berndoJ/BerndoKeyboard/firmware/doc/latex/index.tex

\hypertarget{index_intro_sec}{}\doxysection{Introduction}\label{index_intro_sec}
This is the documentation for the Berndo\+Keyboard-\/\+Firmware project.
