berndoJ/BerndoKeyboard/firmware/doc/latex/main_8h.tex

\hypertarget{main_8h}{}\doxysection{app/inc/main.h File Reference}
\label{main_8h}\index{app/inc/main.h@{app/inc/main.h}}

The main entry point of this application.  

\doxysubsection*{Functions}
\begin{DoxyCompactItemize}
\item 
int \mbox{\hyperlink{main_8h_a840291bc02cba5474a4cb46a9b9566fe}{main}} (void)
\begin{DoxyCompactList}\small\item\em Main function entry point of this application. This function is called by the startup assembly file startup\+\_\+stm32f103xe.\+s. \end{DoxyCompactList}\end{DoxyCompactItemize}

\doxysubsection{Detailed Description}
The main entry point of this application. 

\begin{DoxyDate}{Date}
03.\+01.\+2020
\end{DoxyDate}
\begin{DoxyAuthor}{Author}
Johannes Berndorfer (berndoJ) 
\end{DoxyAuthor}
\begin{DoxyCopyright}{Copyright}
Copyright (c) 2020 by Johannes Berndorfer (berndoJ) 
\end{DoxyCopyright}

\doxysubsection{Function Documentation}
\mbox{\Hypertarget{main_8h_a840291bc02cba5474a4cb46a9b9566fe}\label{main_8h_a840291bc02cba5474a4cb46a9b9566fe}} 
\index{main.h@{main.h}!main@{main}}
\index{main@{main}!main.h@{main.h}}
\doxysubsubsection{\texorpdfstring{main()}{main()}}
{\footnotesize\ttfamily int main (\begin{DoxyParamCaption}\item[{void}]{ }\end{DoxyParamCaption})}

Main function entry point of this application. This function is called by the startup assembly file startup\+\_\+stm32f103xe.\+s. 

\begin{DoxyReturn}{Returns}
Status code. 
\end{DoxyReturn}
