berndoJ/BerndoKeyboard/hardware/BerndoKeyboard-Switchboard/BerndoKeyboard-Switchboard.PcbDoc.htm

Reporting Options

# File in Previous Format

Date | : | 11.01.2020
Time | : | 12:33:09
Filename | : | C:\Users\Johannes\Documents\GitHub\BerndoKeyboard\hardware\BerndoKeyboard-Switchboard\BerndoKeyboard-Switchboard.PcbDoc

Version | Warning

This file was generated by an earlier version of the software
