berndoJ/BerndoKeyboard/kb_layout/keyboard-layout.png

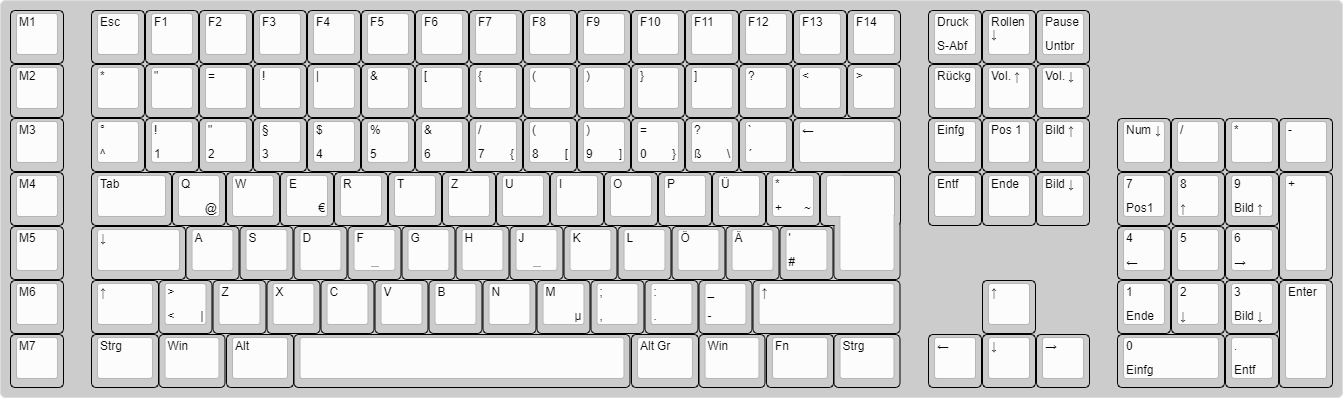
kb_layout/keyboard-layout.png
