berndoJ/BerndoKeyboard/hardware/BerndoKeyboard-Switchboard/BerndoKeyboard-Switchboard-OrderList-LCSC.xlsx

Count | Part Ref | P/N
15 | CCER000002 | C1525
1 | CCER000013 | C70464
132 | D000002 | C77978
1 | TVS000004 | C7519
11 | LED000007 | C114586
26 | R000016 | C60490
7 | R000006 | C114759
2 | R000017 | C105872
1 | R000020 | C163475
1 | R000021 | C327333
2 | IC000051 | C128392
1 | IC000052 | C7843
