berndoJ/BerndoKeyboard/hardware/BerndoKeyboard-Switchboard/BerndoKeyboard-Switchboard-BillOfMaterials.xlsx

Sheet: Raw BOM Data
Comment | Description | Designator | Footprint | LibRef | Quantity | Internal Part Number | Supplier 1 | Supplier Order Qty 1 | Supplier Unit Price 1 | Supplier Subtotal per Board 1 | Supplier Part Number 1
PTS645SL50SMTR92LFS | BTN TACT SPST-NO 12V 50mA SMD BLACK | BTN1 | BTN-SMD-PTS645-CK | PTS645SL50SMTR92LFS | 1 | BTN000006 | Digi-Key | 1 | 0.27882 | 0.27882 | CKN9088CT-ND
MX1A-E1NW | BTN CHERRY MX BLUE SPST-NO 12V 10mA | BTN2, BTN3, BTN4, BTN5, BTN6, BTN7, BTN8, BTN9, BTN10, BTN11, BTN12, BTN13, BTN14, BTN15, BTN16, BTN17, BTN18, BTN19, BTN20, BTN21, BTN22, BTN23, BTN24, BTN25, BTN26, BTN27, BTN28, BTN29, BTN30, BTN31, BTN32, BTN33, BTN34, BTN35, BTN36, BTN37, BTN38, BTN39, BTN40, BTN41, BTN42, BTN43, BTN44, BTN45, BTN46, BTN47, BTN48, BTN49, BTN50, BTN51, BTN52, BTN53, BTN54, BTN55, BTN56, BTN57, BTN58, BTN59, BTN60, BTN61, BTN62, BTN63, BTN64, BTN65, BTN66, BTN67, BTN68, BTN69, BTN70, BTN71, BTN72, BTN73, BTN74, BTN75, BTN76, BTN77, BTN78, BTN79, BTN80, BTN81, BTN82, BTN83, BTN84, BTN85, BTN86, BTN87, BTN88, BTN89, BTN90, BTN91, BTN92, BTN93, BTN94, BTN95, BTN96, BTN97, BTN98, BTN99, BTN100, BTN101, BTN102, BTN103, BTN104, BTN105, BTN106, BTN107, BTN108, BTN109, BTN110, BTN111, BTN112, BTN113, BTN114, BTN115, BTN116, BTN117, BTN118, BTN119, BTN120, BTN121, BTN122, BTN123, BTN124, BTN125, BTN126, BTN127, BTN128, BTN129, BTN130, BTN131, BTN132, BTN133 | BTN-THT-MX-CHERRY | MX1A-E1NW | 132 | BTN000004 | Digi-Key | 132 | 0.66558 | 87.86 | CH197-ND
10uF 10V | CAP CER 10U 10V X5R 10% SMD 0805 85C SAMSUNG | C1, C17, C18, C19, C21, C22, C23 | CAP-SMD-0805-1.35MM-IPC-MED | CL21A106KPFNNNG | 7 | CCER000039 | Digi-Key | 7 | 0.11693 | 0.81848 | 1276-6456-1-ND
100nF 16V | CAP CER 100N 16V X7R 10% SMD 0402 125C SAMSUNG | C2, C3, C4, C5, C6, C7, C8, C9, C10, C11, C12, C13, C14, C15, C16 | CAP-SMD-0402-0.55MM-IPC-MED | CL05B104KO5NNNC | 15 | CCER000002 | Digi-Key | 15 | 0.02159 | 0.32379 | 1276-1001-6-ND
22pF 50V | CAP CER 22P 50V C0G 5% SMD 0402 125C SAMSUNG | C20 | CAP-SMD-0402-0.55MM-IPC-MED | CL05C220JB5NNNC | 1 | CCER000013 | Digi-Key | 1 | 0.08994 | 0.08994 | 1276-1116-1-ND
1775838-2 | CON MINI PCIE CARD EDGE 52POS SMD | CN1 | CON-SMD-PCIE-MINI-52POS-1775838-2-TE | 1775838-2 | 1 | CON000010 | Digi-Key | 1 | 0.68356 | 0.68356 | A123340CT-ND
3220-10-0300-00 | CON PINHDR SMD 1.27MM SHIELDED KEYED CNC TECH 10POS | CN3 | CON-SMD-PINHEADER-SHIELDED-1.27MM-10POS-2X5-3220-10-0300-00-CNC-TECH | 3220-10-0300-00 | 1 | CON000024 | Digi-Key | 1 | 0.66558 | 0.66558 | 1175-1629-ND
PRPC003SAAN-RC | CON PINHDR 2.54MM 1x03 | CN4 | CON-THT-PINHEADER-2.54MM-3POS-1X3 | PRPC003SAAN-RC | 1 | CON000025 | Digi-Key | 1 | 0.10793 | 0.10793 | S1011EC-03-ND
USB4085-GF-A | CON USB TYPE C THROUGH HOLE 16POS | CN5 | CON-THT-USB-C-16POS-USB4085-GCT | USB4085-GF-A | 1 | CON000028 | Digi-Key |  |  |  | 2073-USB4085-GF-ACT-ND
1N4148W-TP | DIODE GEN-PURP 100V 150mA 1V25@150mA SMD SOD-23 | D1, D2, D3, D4, D5, D6, D7, D8, D9, D10, D11, D12, D13, D14, D15, D16, D17, D18, D19, D20, D21, D22, D23, D24, D25, D26, D27, D28, D29, D30, D31, D32, D33, D34, D35, D36, D37, D38, D39, D40, D41, D42, D43, D44, D45, D46, D47, D48, D49, D50, D51, D52, D53, D54, D55, D56, D57, D58, D59, D60, D61, D62, D63, D64, D65, D66, D67, D68, D69, D70, D71, D72, D73, D74, D75, D76, D77, D78, D79, D80, D81, D82, D83, D84, D85, D86, D87, D88, D89, D90, D91, D92, D93, D94, D95, D96, D97, D98, D99, D100, D101, D102, D103, D104, D105, D106, D107, D108, D109, D110, D111, D112, D113, D114, D115, D116, D117, D118, D119, D120, D121, D122, D123, D124, D125, D126, D127, D128, D129, D130, D131, D132 | D-SMD-SOD-123-MICRO-COMMERCIAL-COMPONENTS | 1N4148W-TP | 132 | D000002 | Digi-Key | 132 | 0.03058 | 4.04 | 1N4148WTPMSCT-ND
USBLC6-2SC6 | TVS DIODE 2CH 5.25V 17V USB2.0 SOT23-6L | D133 | SOT-23-6L-H1.45MM-ST | USBLC6-2SC6 | 1 | TVS000004 | Digi-Key | 1 | 0.42273 | 0.42273 | 497-5235-1-ND
7440430022 | IND 2U2 2A5 28mR 30% SMD FERRITE WURTH | L1 | IND-SMD-7440430022-3MM | 7440430022 | 1 | L000009 | Digi-Key | 1 | 1.29 | 1.29 | 732-1095-1-ND
WS2812B | LED RGB-ADDRESSABLE SERIAL 5050 | LED1, LED2, LED3, LED4, LED5, LED6, LED7, LED8, LED9, LED10, LED11 | LED-SMD-4-SMD-5050-WS2812B | WS2812B | 11 | LED000007
MM60-EZH059-B5-R650 | CARD LATCH MINI PCIE 3.05mm HEIGHT | MECH1 | CON-SMD-PCIE-MINI-LATCH-0POS-MM60-EZH059-B5-R650-JAE | MM60-EZH059-B5-R650 | 1 | MISC000005 | Digi-Key | 1 | 1.1 | 1.1 | 670-2277-1-ND
10kR 1% | RES 10K 1% 1/16W SMD 0402 YAEGO | R1, R2, R3, R4, R5, R6, R7, R8, R9, R10, R11, R12, R13, R14, R15, R16, R17, R18, R26, R27, R28, R29, R30, R31, R34, R37 | RES-SMD-0402-0.4MM-IPC-MED | RC0402FR-0710KL | 26 | R000016 | Digi-Key | 26 | 0.01439 | 0.37416 | 311-10.0KLRCT-ND
1.5kR 1% | RES 1K5 1% 1/16W SMD 0402 YAEGO | R19, R20, R21, R22, R23, R24, R25 | RES-SMD-0402-0.4MM-IPC-MED | RC0402FR-071K5L | 7 | R000006 | Digi-Key | 7 | 0.08994 | 0.6296 | 311-1.50KLRCT-ND
RC0402FR-075K1L | RES 5K1 1% 1/16W SMD 0402 YAEGO | R35, R36 | RES-SMD-0402-0.4MM-IPC-MED | RC0402FR-075K1L | 2 | R000017 | Digi-Key | 2 | 0.08994 | 0.17989 | 311-5.10KLRCT-ND
RC0402FR-07270KL | RES 270K 1% 1/16W SMD 0402 YAEGO | R38 | RES-SMD-0402-0.4MM-IPC-MED | RC0402FR-07270KL | 1 | R000020 | Digi-Key | 1 | 0.08994 | 0.08994 | 311-270KLRCT-ND
RC0402FR-0760K4L | RES 60K4 1% 1/16W SMD 0402 YAEGO | R39 | RES-SMD-0402-0.4MM-IPC-MED | RC0402FR-0760K4L | 1 | R000021 | Digi-Key | 1 | 0.08994 | 0.08994 | 311-60.4KLRCT-ND
IM-VBAT-TP |  | TP1 | TP-SMD-CIRCULAR-1MM | TESTPOINT_CIRCULAR_1MM | 1
LED_DATA_IN |  | TP2 | TP-SMD-CIRCULAR-1MM | TESTPOINT_CIRCULAR_1MM | 1
RGB_LED_DATA_OUT |  | TP3 | TP-SMD-CIRCULAR-1MM | TESTPOINT_CIRCULAR_1MM | 1
USBC_SBU1 |  | TP4 | TP-SMD-CIRCULAR-1MM | TESTPOINT_CIRCULAR_1MM | 1
USBC_SBU2 |  | TP5 | TP-SMD-CIRCULAR-1MM | TESTPOINT_CIRCULAR_1MM | 1
PCA9555PW,118 | IC I/O EXPANDER I2C 16B 24TSSOP | U1, U2 | TSSOP-24-H1.1MM-P0.65MM-NXP | PCA9555PW,118 | 2 | IC000051 | Digi-Key | 2 | 1.53 | 3.06 | 568-1058-1-ND
SN74LVC1T45DBVR | IC LEVEL SHIFTER BIDIR TRISTATE 1CH SOT-23-6 1V65-5V5 | U3 | SOT-23-6-H1.45MM-TI | SN74LVC1T45DBVR | 1 | IC000052 | Digi-Key | 1 | 0.53966 | 0.53966 | 296-16843-1-ND
AP3419KTTR-G1 | IC REGULATOR BUCK 2A SYNC 1MHZ SOT-23-6 | U4 | SOT-23-6-H1MM-DIODES-INC | AP3419KTTR-G1 | 1 | IC000028 | Digi-Key |  |  |  | AP3419KTTR-G1DICT-ND

Sheet: BOM
Bill of Materials
BerndoKeyboard-Switchboard
Board Revision A
Part | Description | Comment / Value | Quantity | Internal P/N | Schematic Reference | SUP1 | SUP1-P/N | SUP1-UP | SUP1-ST | SUP1-COM | SUP2 | SUP2-P/N | SUP2-UP | SUP2-ST | SUP2-COM | BOM Comment
PTS645SL50SMTR92LFS | BTN TACT SPST-NO 12V 50mA SMD BLACK | PTS645SL50SMTR92LFS | 1 | BTN000006 | BTN1 | Digi-Key | CKN9088CT-ND | €0.2788 | €0.2788
MX1A-E1NW | BTN CHERRY MX BLUE SPST-NO 12V 10mA | MX1A-E1NW | 132 | BTN000004 | BTN2, BTN3, BTN4, BTN5, BTN6, BTN7, BTN8, BTN9, BTN10, BTN11, BTN12, BTN13, BTN14, BTN15, BTN16, BTN17, BTN18, BTN19, BTN20, BTN21, BTN22, BTN23, BTN24, BTN25, BTN26, BTN27, BTN28, BTN29, BTN30, BTN31, BTN32, BTN33, BTN34, BTN35, BTN36, BTN37, BTN38, BTN39, BTN40, BTN41, BTN42, BTN43, BTN44, BTN45, BTN46, BTN47, BTN48, BTN49, BTN50, BTN51, BTN52, BTN53, BTN54, BTN55, BTN56, BTN57, BTN58, BTN59, BTN60, BTN61, BTN62, BTN63, BTN64, BTN65, BTN66, BTN67, BTN68, BTN69, BTN70, BTN71, BTN72, BTN73, BTN74, BTN75, BTN76, BTN77, BTN78, BTN79, BTN80, BTN81, BTN82, BTN83, BTN84, BTN85, BTN86, BTN87, BTN88, BTN89, BTN90, BTN91, BTN92, BTN93, BTN94, BTN95, BTN96, BTN97, BTN98, BTN99, BTN100, BTN101, BTN102, BTN103, BTN104, BTN105, BTN106, BTN107, BTN108, BTN109, BTN110, BTN111, BTN112, BTN113, BTN114, BTN115, BTN116, BTN117, BTN118, BTN119, BTN120, BTN121, BTN122, BTN123, BTN124, BTN125, BTN126, BTN127, BTN128, BTN129, BTN130, BTN131, BTN132, BTN133 | BERNDOSTOCK |  | €0.0000 | €0.0000
CL21A106KPFNNNG | CAP CER 10U 10V X5R 10% SMD 0805 85C SAMSUNG | 10uF 10V | 7 | CCER000039 | C1, C17, C18, C19, C21, C22, C23 | Digi-Key | 1276-6456-1-ND | €0.1169 | €0.8185
CL05B104KO5NNNC | CAP CER 100N 16V X7R 10% SMD 0402 125C SAMSUNG | 100nF 16V | 15 | CCER000002 | C2, C3, C4, C5, C6, C7, C8, C9, C10, C11, C12, C13, C14, C15, C16 | LCSC | C1525 | €0.0011 | €0.1100 | MOQ: 100 - STEP: 100 | Digi-Key | 1276-1001-6-ND | €0.0216 | €0.3238
CL05C220JB5NNNC | CAP CER 22P 50V C0G 5% SMD 0402 125C SAMSUNG | 22pF 50V | 1 | CCER000013 | C20 | LCSC | C70464 | €0.0027 | €0.1300 | MOQ: 50 - STEP: 50 | Digi-Key | 1276-1116-1-ND | €0.0899 | €0.0899
1775838-2 | CON MINI PCIE CARD EDGE 52POS SMD | 1775838-2 | 1 | CON000010 | CN1 | Digi-Key | A123340CT-ND | €0.6836 | €0.6836
3220-10-0300-00 | CON PINHDR SMD 1.27MM SHIELDED KEYED CNC TECH 10POS | 3220-10-0300-00 | 1 | CON000024 | CN3 | Digi-Key | 1175-1629-ND | €0.6656 | €0.6656
PRPC003SAAN-RC | CON PINHDR 2.54MM 1x03 | PRPC003SAAN-RC | 1 | CON000025 | CN4 | Digi-Key | S1011EC-03-ND | €0.1079 | €0.1079
USB4085-GF-A | CON USB TYPE C THROUGH HOLE 16POS | USB4085-GF-A | 1 | CON000028 | CN5 | Digi-Key | 2073-USB4085-GF-ACT-ND | €1.2400 | €1.2400
1N4148W-TP | DIODE GEN-PURP 100V 150mA 1V25@150mA SMD SOD-23 | 1N4148W-TP | 132 | D000002 | D1, D2, D3, D4, D5, D6, D7, D8, D9, D10, D11, D12, D13, D14, D15, D16, D17, D18, D19, D20, D21, D22, D23, D24, D25, D26, D27, D28, D29, D30, D31, D32, D33, D34, D35, D36, D37, D38, D39, D40, D41, D42, D43, D44, D45, D46, D47, D48, D49, D50, D51, D52, D53, D54, D55, D56, D57, D58, D59, D60, D61, D62, D63, D64, D65, D66, D67, D68, D69, D70, D71, D72, D73, D74, D75, D76, D77, D78, D79, D80, D81, D82, D83, D84, D85, D86, D87, D88, D89, D90, D91, D92, D93, D94, D95, D96, D97, D98, D99, D100, D101, D102, D103, D104, D105, D106, D107, D108, D109, D110, D111, D112, D113, D114, D115, D116, D117, D118, D119, D120, D121, D122, D123, D124, D125, D126, D127, D128, D129, D130, D131, D132 | LCSC | C77978 | €0.0112 | €1.6900 | MOQ: 50 - STEP: 50 | Digi-Key | 1N4148WTPMSCT-ND | €0.0306 | €4.0400
USBLC6-2SC6 | TVS DIODE 2CH 5.25V 17V USB2.0 SOT23-6L | USBLC6-2SC6 | 1 | TVS000004 | D133 | LCSC | C7519 | €0.0699 | €0.3500 | MOQ: 5 - STEP: 5 | Digi-Key | 497-5235-1-ND | €0.4227 | €0.4227
7440430022 | IND 2U2 2A5 28mR 30% SMD FERRITE WURTH | 7440430022 | 1 | L000009 | L1 | Digi-Key | 732-1095-1-ND | €1.2900 | €1.2900
WS2812B | LED RGB-ADDRESSABLE SERIAL 5050 | WS2812B | 11 | LED000007 | LED1, LED2, LED3, LED4, LED5, LED6, LED7, LED8, LED9, LED10, LED11 | LCSC | C114586 | €0.0901 | €1.3500 | MOQ: 5 - STEP: 5
MM60-EZH059-B5-R650 | CARD LATCH MINI PCIE 3.05mm HEIGHT | MM60-EZH059-B5-R650 | 1 | MISC000005 | MECH1 | Digi-Key | 670-2277-1-ND | €1.1000 | €1.1000
RC0402FR-0710KL | RES 10K 1% 1/16W SMD 0402 YAEGO | 10kR 1% | 26 | R000016 | R1, R2, R3, R4, R5, R6, R7, R8, R9, R10, R11, R12, R13, R14, R15, R16, R17, R18, R26, R27, R28, R29, R30, R31, R34, R37 | LCSC | C60490 | €0.0004 | €0.0400 | MOQ: 100 - STEP: 100 | Digi-Key | 311-10.0KLRCT-ND | €0.0144 | €0.3742
RC0402FR-071K5L | RES 1K5 1% 1/16W SMD 0402 YAEGO | 1.5kR 1% | 7 | R000006 | R19, R20, R21, R22, R23, R24, R25 | LCSC | C114759 | €0.0004 | €0.0400 | MOQ: 100 - STEP: 100 | Digi-Key | 311-1.50KLRCT-ND | €0.0899 | €0.6296
RC0402FR-075K1L | RES 5K1 1% 1/16W SMD 0402 YAEGO | RC0402FR-075K1L | 2 | R000017 | R35, R36 | LCSC | C105872 | €0.0004 | €0.0400 | MOQ: 100 - STEP: 100 | Digi-Key | 311-5.10KLRCT-ND | €0.0899 | €0.1799
RC0402FR-07270KL | RES 270K 1% 1/16W SMD 0402 YAEGO | RC0402FR-07270KL | 1 | R000020 | R38 | LCSC | C163475 | €0.0010 | €0.1000 | MOQ: 100 - STEP: 100 | Digi-Key | 311-270KLRCT-ND | €0.0899 | €0.0899
RC0402FR-0760K4L | RES 60K4 1% 1/16W SMD 0402 YAEGO | RC0402FR-0760K4L | 1 | R000021 | R39 | LCSC | C327333 | €0.0005 | €0.0500 | MOQ: 100 - STEP: 100 | Digi-Key | 311-60.4KLRCT-ND | €0.0899 | €0.0899
PCA9555PW,118 | IC I/O EXPANDER I2C 16B 24TSSOP | PCA9555PW,118 | 2 | IC000051 | U1, U2 | LCSC | C128392 | €0.7402 | €1.4800 |  | Digi-Key | 568-1058-1-ND | €1.5300 | €3.0600
SN74LVC1T45DBVR | IC LEVEL SHIFTER BIDIR TRISTATE 1CH SOT-23-6 1V65-5V5 | SN74LVC1T45DBVR | 1 | IC000052 | U3 | LCSC | C7843 | €0.2181 | €0.2181 |  | Digi-Key | 296-16843-1-ND | €0.5397 | €0.5397
AP3419KTTR-G1 | IC REGULATOR BUCK 2A SYNC 1MHZ SOT-23-6 | AP3419KTTR-G1 | 1 | IC000028 | U4 | Mouser | 621-AP3419KTTR-G1 | €0.3690 | €0.3690
 |  |  |  |  |  |  |  | Total BOM Cost / Unit: | €12.1515

Sheet: DigiKey Order List
Count | Part Ref | P/N
1 | BTN000006 | CKN9088CT-ND
7 | CCER000039 | 1276-6456-1-ND
1 | CON000010 | A123340CT-ND
1 | CON000024 | 1175-1629-ND
1 | CON000025 | S1011EC-03-ND
1 | CON000028 | 2073-USB4085-GF-ACT-ND
1 | L000009 | 732-1095-1-ND
1 | MISC000005 | 670-2277-1-ND

Sheet: LCSC Order List
Count | Part Ref | P/N
15 | CCER000002 | C1525
1 | CCER000013 | C70464
132 | D000002 | C77978
1 | TVS000004 | C7519
11 | LED000007 | C114586
26 | R000016 | C60490
7 | R000006 | C114759
2 | R000017 | C105872
1 | R000020 | C163475
1 | R000021 | C327333
2 | IC000051 | C128392
1 | IC000052 | C7843

Sheet: Mouser Order List
Count | Part Ref | P/N
1 | IC000028 | 621-AP3419KTTR-G1
