berndoJ/BerndoKeyboard/hardware/BerndoKeyboard-Switchboard/Project Outputs for BerndoKeyboard-Switchboard/BerndoKeyboard-Switchboard-BOM-Def-09-12-2019.xlsx

Sheet: BOM Report
Bill of Materials |  |  | Bill of Materials for Project [BerndoKeyboard-Switchboard.PrjPcb] (No PCB Document Selected)
Source Data From: |  | BerndoKeyboard-Switchboard.PrjPcb
Project: |  | BerndoKeyboard-Switchboard.PrjPcb
Variant: |  | None
Creation Date: | 09.12.2019 | 11:25
Print Date: | 2019-12-09 | 11:25:44
Footprint | Comment | LibRef | Designator | Description | Quantity
BTN-SMD-PTS645-CK | PTS645SL50SMTR92LFS | PTS645SL50SMTR92LFS | BTN1 | BTN TACT SPST-NO 12V 50mA SMD BLACK | 1
BTN-THT-MX-CHERRY | MX1A-E1NW | MX1A-E1NW | BTN2, BTN3, BTN4, BTN5, BTN6, BTN7, BTN8, BTN9, BTN10, BTN11, BTN12, BTN13, BTN14, BTN15, BTN16, BTN17, BTN18, BTN19, BTN20, BTN21, BTN22, BTN23, BTN24, BTN25, BTN26, BTN27, BTN28, BTN29, BTN30, BTN31, BTN32, BTN33, BTN34, BTN35, BTN36, BTN37, BTN38, BTN39, BTN40, BTN41, BTN42, BTN43, BTN44, BTN45, BTN46, BTN47, BTN48, BTN49, BTN50, BTN51, BTN52, BTN53, BTN54, BTN55, BTN56, BTN57, BTN58, BTN59, BTN60, BTN61, BTN62, BTN63, BTN64, BTN65, BTN66, BTN67, BTN68, BTN69, BTN70, BTN71, BTN72, BTN73, BTN74, BTN75, BTN76, BTN77, BTN78, BTN79, BTN80, BTN81, BTN82, BTN83, BTN84, BTN85, BTN86, BTN87, BTN88, BTN89, BTN90, BTN91, BTN92, BTN93, BTN94, BTN95, BTN96, BTN97, BTN98, BTN99, BTN100, BTN101, BTN102, BTN103, BTN104, BTN105, BTN106, BTN107, BTN108, BTN109, BTN110, BTN111, BTN112, BTN113, BTN114, BTN115, BTN116, BTN117, BTN118, BTN119, BTN120, BTN121, BTN122, BTN123, BTN124, BTN125, BTN126, BTN127, BTN128, BTN129, BTN130, BTN131, BTN132, BTN133 | BTN CHERRY MX BLUE SPST-NO 12V 10mA | 132
CAP-SMD-0805-1.35MM-IPC-MED | 10uF 10V | CL21A106KPFNNNG | C1, C17, C18, C19, C21, C22, C23 | CAP CER 10U 10V X5R 10% SMD 0805 85C SAMSUNG | 7
CAP-SMD-0402-0.55MM-IPC-MED | 100nF 16V | CL05B104KO5NNNC | C2, C3, C4, C5, C6, C7, C8, C9, C10, C11, C12, C13, C14, C15, C16 | CAP CER 100N 16V X7R 10% SMD 0402 125C SAMSUNG | 15
CAP-SMD-0402-0.55MM-IPC-MED | 22pF 50V | CL05C220JB5NNNC | C20 | CAP CER 22P 50V C0G 5% SMD 0402 125C SAMSUNG | 1
CON-SMD-PCIE-MINI-52POS-1775838-2-TE | 1775838-2 | 1775838-2 | CN1 | CON MINI PCIE CARD EDGE 52POS SMD | 1
CON-THT-PINHEADER-2.54MM-20POS-2X10 | PRPC010DAAN-RC | PRPC010DAAN-RC | CN2 | CON PINHDR 2.54MM 2x10 | 1
CON-SMD-PINHEADER-SHIELDED-1.27MM-10POS-2X5-3220-10-0300-00-CNC-TECH | 3220-10-0300-00 | 3220-10-0300-00 | CN3 | CON PINHDR SMD 1.27MM SHIELDED KEYED CNC TECH 10POS | 1
CON-THT-PINHEADER-2.54MM-3POS-1X3 | PRPC003SAAN-RC | PRPC003SAAN-RC | CN4 | CON PINHDR 2.54MM 1x03 | 1
CON-THT-USB-C-16POS-USB4085-GCT | USB4085-GF-A | USB4085-GF-A | CN5 | CON USB TYPE C THROUGH HOLE 16POS | 1
D-SMD-SOD-123-MICRO-COMMERCIAL-COMPONENTS | 1N4148W-TP | 1N4148W-TP | D1, D2, D3, D4, D5, D6, D7, D8, D9, D10, D11, D12, D13, D14, D15, D16, D17, D18, D19, D20, D21, D22, D23, D24, D25, D26, D27, D28, D29, D30, D31, D32, D33, D34, D35, D36, D37, D38, D39, D40, D41, D42, D43, D44, D45, D46, D47, D48, D49, D50, D51, D52, D53, D54, D55, D56, D57, D58, D59, D60, D61, D62, D63, D64, D65, D66, D67, D68, D69, D70, D71, D72, D73, D74, D75, D76, D77, D78, D79, D80, D81, D82, D83, D84, D85, D86, D87, D88, D89, D90, D91, D92, D93, D94, D95, D96, D97, D98, D99, D100, D101, D102, D103, D104, D105, D106, D107, D108, D109, D110, D111, D112, D113, D114, D115, D116, D117, D118, D119, D120, D121, D122, D123, D124, D125, D126, D127, D128, D129, D130, D131, D132 | DIODE GEN-PURP 100V 150mA 1V25@150mA SMD SOD-23 | 132
SOT-23-6L-H1.45MM-ST | USBLC6-2SC6 | USBLC6-2SC6 | D133 | TVS DIODE 2CH 5.25V 17V USB2.0 SOT23-6L | 1
IND-SMD-7440430022-3MM | 7440430022 | 7440430022 | L1 | IND 2U2 2A5 28mR 30% SMD FERRITE WURTH | 1
LED-SMD-4-SMD-5050-WS2812B | WS2812B | WS2812B | LED1, LED2, LED3, LED4, LED5, LED6, LED7, LED8, LED9, LED10, LED11 | LED RGB-ADDRESSABLE SERIAL 5050 | 11
CON-SMD-PCIE-MINI-LATCH-0POS-MM60-EZH059-B5-R650-JAE | MM60-EZH059-B5-R650 | MM60-EZH059-B5-R650 | MECH1 | CARD LATCH MINI PCIE 3.05mm HEIGHT | 1
RES-SMD-0402-0.4MM-IPC-MED | 10kR 1% | RC0402FR-0710KL | R1, R2, R3, R4, R5, R6, R7, R8, R9, R10, R11, R12, R13, R14, R15, R16, R17, R18, R26, R27, R28, R29, R30, R31, R34, R37 | RES 10K 1% 1/16W SMD 0402 YAEGO | 26
RES-SMD-0402-0.4MM-IPC-MED | 1.5kR 1% | RC0402FR-071K5L | R19, R20, R21, R22, R23, R24, R25, R32, R33 | RES 1K5 1% 1/16W SMD 0402 YAEGO | 9
RES-SMD-0402-0.4MM-IPC-MED | RC0402FR-075K1L | RC0402FR-075K1L | R35, R36 | RES 5K1 1% 1/16W SMD 0402 YAEGO | 2
RES-SMD-0402-0.4MM-IPC-MED | RC0402FR-07270KL | RC0402FR-07270KL | R38 | RES 270K 1% 1/16W SMD 0402 YAEGO | 1
RES-SMD-0402-0.4MM-IPC-MED | RC0402FR-0760K4L | RC0402FR-0760K4L | R39 | RES 60K4 1% 1/16W SMD 0402 YAEGO | 1
TP-SMD-CIRCULAR-1MM | IM-VBAT-TP | TESTPOINT_CIRCULAR_1MM | TP1 |  | 1
TP-SMD-CIRCULAR-1MM | LED_DATA_IN | TESTPOINT_CIRCULAR_1MM | TP2 |  | 1
TP-SMD-CIRCULAR-1MM | RGB_LED_DATA_OUT | TESTPOINT_CIRCULAR_1MM | TP3 |  | 1
TP-SMD-CIRCULAR-1MM | USBC_SBU1 | TESTPOINT_CIRCULAR_1MM | TP4 |  | 1
TP-SMD-CIRCULAR-1MM | USBC_SBU2 | TESTPOINT_CIRCULAR_1MM | TP5 |  | 1
TSSOP-24-H1.1MM-P0.65MM-NXP | PCA9555PW,118 | PCA9555PW,118 | U1, U2 | IC I/O EXPANDER I2C 16B 24TSSOP | 2
SOT-23-6-H1.45MM-TI | SN74LVC1T45DBVR | SN74LVC1T45DBVR | U3 | IC LEVEL SHIFTER BIDIR TRISTATE 1CH SOT-23-6 1V65-5V5 | 1
SOT-23-6-H1MM-DIODES-INC | AP3419KTTR-G1 | AP3419KTTR-G1 | U4 | IC REGULATOR BUCK 2A SYNC 1MHZ SOT-23-6 | 1
 |  |  |  |  | 355
Approved |  | Notes

Sheet: Project Information
Project Full Path | C:\Users\Johannes\Documents\GitHub\BerndoKeyboard\hardware\BerndoKeyboard-Switchboard\BerndoKeyboard-Switchboard.PrjPcb
Project Filename | BerndoKeyboard-Switchboard.PrjPcb
Variant Name | None
Data-Source Filename | BerndoKeyboard-Switchboard.PrjPcb
Data-Source Full Path | C:\Users\Johannes\Documents\GitHub\BerndoKeyboard\hardware\BerndoKeyboard-Switchboard\BerndoKeyboard-Switchboard.PrjPcb
Title | Bill of Materials for Project [BerndoKeyboard-Switchboard.PrjPcb] (No PCB Document Selected)
Total Quantity | 355
Report Time | 11:25
Report Date | 09.12.2019
Report Date & Tine | 09.12.2019 11:25
Output Name | Bill of Materials
Output Type | BOM_PartType
Output Generator Name | BOM
Output Generator Description | Bill of Materials
