berndoJ/BerndoKeyboard/hardware/BerndoKeyboard-Switchboard/Project Outputs for BerndoKeyboard-Switchboard/BerndoKeyboard-Switchboard-BOM-Purchase-09-12-2019.xlsx

Sheet: Part List Report
 | Component list |  |  | Bill of Materials for Project [BerndoKeyboard-Switchboard.PrjPcb] (No PCB Document Selected)
 | Source Data From: |  |  | BerndoKeyboard-Switchboard.PrjPcb
 | Project: |  |  | BerndoKeyboard-Switchboard.PrjPcb
 | Variant: |  |  | None
 | Report Date: |  | 09.12.2019 | 11:24
 | Print Date: |  | 2019-12-09 | 11:24:44
# | LibRef | Manufacturer 1 | Manufacturer Part Number 1 | PartType | Description | Footprint | #Column Name Error:' PackageReference | Quantity
1 | PTS645SL50SMTR92LFS | ITT C&K | PTS645SL50SMTR92LFS | PTS645SL50SMTR92LFS | BTN TACT SPST-NO 12V 50mA SMD BLACK | BTN-SMD-PTS645-CK |  | 1
2 | MX1A-E1NW | Cherry | MX1A-E1NW | MX1A-E1NW | BTN CHERRY MX BLUE SPST-NO 12V 10mA | BTN-THT-MX-CHERRY |  | 132
3 | CL21A106KPFNNNG | Sams | CL21A106KPFNNNG | 10uF 10V | CAP CER 10U 10V X5R 10% SMD 0805 85C SAMSUNG | CAP-SMD-0805-1.35MM-IPC-MED |  | 7
4 | CL05B104KO5NNNC | Samsung | CL05B104KO5NNNC | 100nF 16V | CAP CER 100N 16V X7R 10% SMD 0402 125C SAMSUNG | CAP-SMD-0402-0.55MM-IPC-MED |  | 15
5 | CL05C220JB5NNNC | Samsung | CL05C220JB5NNNC | 22pF 50V | CAP CER 22P 50V C0G 5% SMD 0402 125C SAMSUNG | CAP-SMD-0402-0.55MM-IPC-MED |  | 1
6 | 1775838-2 | TE Connectivity AMP | 1775838-2 | 1775838-2 | CON MINI PCIE CARD EDGE 52POS SMD | CON-SMD-PCIE-MINI-52POS-1775838-2-TE |  | 1
7 | PRPC010DAAN-RC | Sullins | PRPC010DAAN-RC | PRPC010DAAN-RC | CON PINHDR 2.54MM 2x10 | CON-THT-PINHEADER-2.54MM-20POS-2X10 |  | 1
8 | 3220-10-0300-00 | CNC Tech | 3220-10-0300-00 | 3220-10-0300-00 | CON PINHDR SMD 1.27MM SHIELDED KEYED CNC TECH 10POS | CON-SMD-PINHEADER-SHIELDED-1.27MM-10POS-2X5-3220-10-0300-00-CNC-TECH |  | 1
9 | PRPC003SAAN-RC | Sullins | PRPC003SAAN-RC | PRPC003SAAN-RC | CON PINHDR 2.54MM 1x03 | CON-THT-PINHEADER-2.54MM-3POS-1X3 |  | 1
10 | USB4085-GF-A | Global Connector Technology | USB4085-GF-A | USB4085-GF-A | CON USB TYPE C THROUGH HOLE 16POS | CON-THT-USB-C-16POS-USB4085-GCT |  | 1
11 | 1N4148W-TP | MCC | 1N4148W-TP | 1N4148W-TP | DIODE GEN-PURP 100V 150mA 1V25@150mA SMD SOD-23 | D-SMD-SOD-123-MICRO-COMMERCIAL-COMPONENTS |  | 132
12 | USBLC6-2SC6 | STMicroelectronics | USBLC6-2SC6 | USBLC6-2SC6 | TVS DIODE 2CH 5.25V 17V USB2.0 SOT23-6L | SOT-23-6L-H1.45MM-ST |  | 1
13 | 7440430022 | Wurth Electronics | 7440430022 | 7440430022 | IND 2U2 2A5 28mR 30% SMD FERRITE WURTH | IND-SMD-7440430022-3MM |  | 1
14 | WS2812B |  |  | WS2812B | LED RGB-ADDRESSABLE SERIAL 5050 | LED-SMD-4-SMD-5050-WS2812B |  | 11
15 | MM60-EZH059-B5-R650 | JAE Electronics | MM60-EZH059-B5-R650 | MM60-EZH059-B5-R650 | CARD LATCH MINI PCIE 3.05mm HEIGHT | CON-SMD-PCIE-MINI-LATCH-0POS-MM60-EZH059-B5-R650-JAE |  | 1
16 | RC0402FR-0710KL | Yageo | RC0402FR-0710KL | 10kR 1% | RES 10K 1% 1/16W SMD 0402 YAEGO | RES-SMD-0402-0.4MM-IPC-MED |  | 26
17 | RC0402FR-071K5L | Yageo | RC0402FR-071K5L | 1.5kR 1% | RES 1K5 1% 1/16W SMD 0402 YAEGO | RES-SMD-0402-0.4MM-IPC-MED |  | 9
18 | RC0402FR-075K1L | Yageo | RC0402FR-075K1L | RC0402FR-075K1L | RES 5K1 1% 1/16W SMD 0402 YAEGO | RES-SMD-0402-0.4MM-IPC-MED |  | 2
19 | RC0402FR-07270KL | Yageo | RC0402FR-07270KL | RC0402FR-07270KL | RES 270K 1% 1/16W SMD 0402 YAEGO | RES-SMD-0402-0.4MM-IPC-MED |  | 1
20 | RC0402FR-0760K4L | Yageo | RC0402FR-0760K4L | RC0402FR-0760K4L | RES 60K4 1% 1/16W SMD 0402 YAEGO | RES-SMD-0402-0.4MM-IPC-MED |  | 1
21 | TESTPOINT_CIRCULAR_1MM |  |  | IM-VBAT-TP |  | TP-SMD-CIRCULAR-1MM |  | 1
22 | TESTPOINT_CIRCULAR_1MM |  |  | LED_DATA_IN |  | TP-SMD-CIRCULAR-1MM |  | 1
23 | TESTPOINT_CIRCULAR_1MM |  |  | RGB_LED_DATA_OUT |  | TP-SMD-CIRCULAR-1MM |  | 1
24 | TESTPOINT_CIRCULAR_1MM |  |  | USBC_SBU1 |  | TP-SMD-CIRCULAR-1MM |  | 1
25 | TESTPOINT_CIRCULAR_1MM |  |  | USBC_SBU2 |  | TP-SMD-CIRCULAR-1MM |  | 1
26 | PCA9555PW,118 | NXP Semiconductors | PCA9555PW,118 | PCA9555PW,118 | IC I/O EXPANDER I2C 16B 24TSSOP | TSSOP-24-H1.1MM-P0.65MM-NXP |  | 2
27 | SN74LVC1T45DBVR | Texas Instruments | SN74LVC1T45DBVR | SN74LVC1T45DBVR | IC LEVEL SHIFTER BIDIR TRISTATE 1CH SOT-23-6 1V65-5V5 | SOT-23-6-H1.45MM-TI |  | 1
28 | AP3419KTTR-G1 | Diodes | AP3419KTTR-G1 | AP3419KTTR-G1 | IC REGULATOR BUCK 2A SYNC 1MHZ SOT-23-6 | SOT-23-6-H1MM-DIODES-INC |  | 1
Approved |  |  |  | Notes |  |  |  | 355

Sheet: Project Information
Project Full Path | C:\Users\Johannes\Documents\GitHub\BerndoKeyboard\hardware\BerndoKeyboard-Switchboard\BerndoKeyboard-Switchboard.PrjPcb
Project Filename | BerndoKeyboard-Switchboard.PrjPcb
Variant Name | None
Data-Source Filename | BerndoKeyboard-Switchboard.PrjPcb
Data-Source Full Path | C:\Users\Johannes\Documents\GitHub\BerndoKeyboard\hardware\BerndoKeyboard-Switchboard\BerndoKeyboard-Switchboard.PrjPcb
Title | Bill of Materials for Project [BerndoKeyboard-Switchboard.PrjPcb] (No PCB Document Selected)
Total Quantity | 355
Report Time | 11:24
Report Date | 09.12.2019
Report Date & Tine | 09.12.2019 11:24
Output Name | Bill of Materials
Output Type | BOM_PartType
Output Generator Name | BOM
Output Generator Description | Bill of Materials
Total Actual Price | <Parameter TotalActualPrice not found>
Total Target Price | <Parameter TotalTargetPrice not found>
