berndoJ/BerndoKeyboard/hardware/BerndoKeyboard-Switchboard/BerndoKeyboard-Switchboard-OrderList-Mouser.xlsx

Count | Part Ref | P/N
1 | IC000028 | 621-AP3419KTTR-G1
