berndoJ/BerndoKeyboard/hardware/BerndoKeyboard-Switchboard/Project Outputs for BerndoKeyboard-Switchboard/Schematic Print/BerndoKeyboard-Switchboard-Schematics.PDF

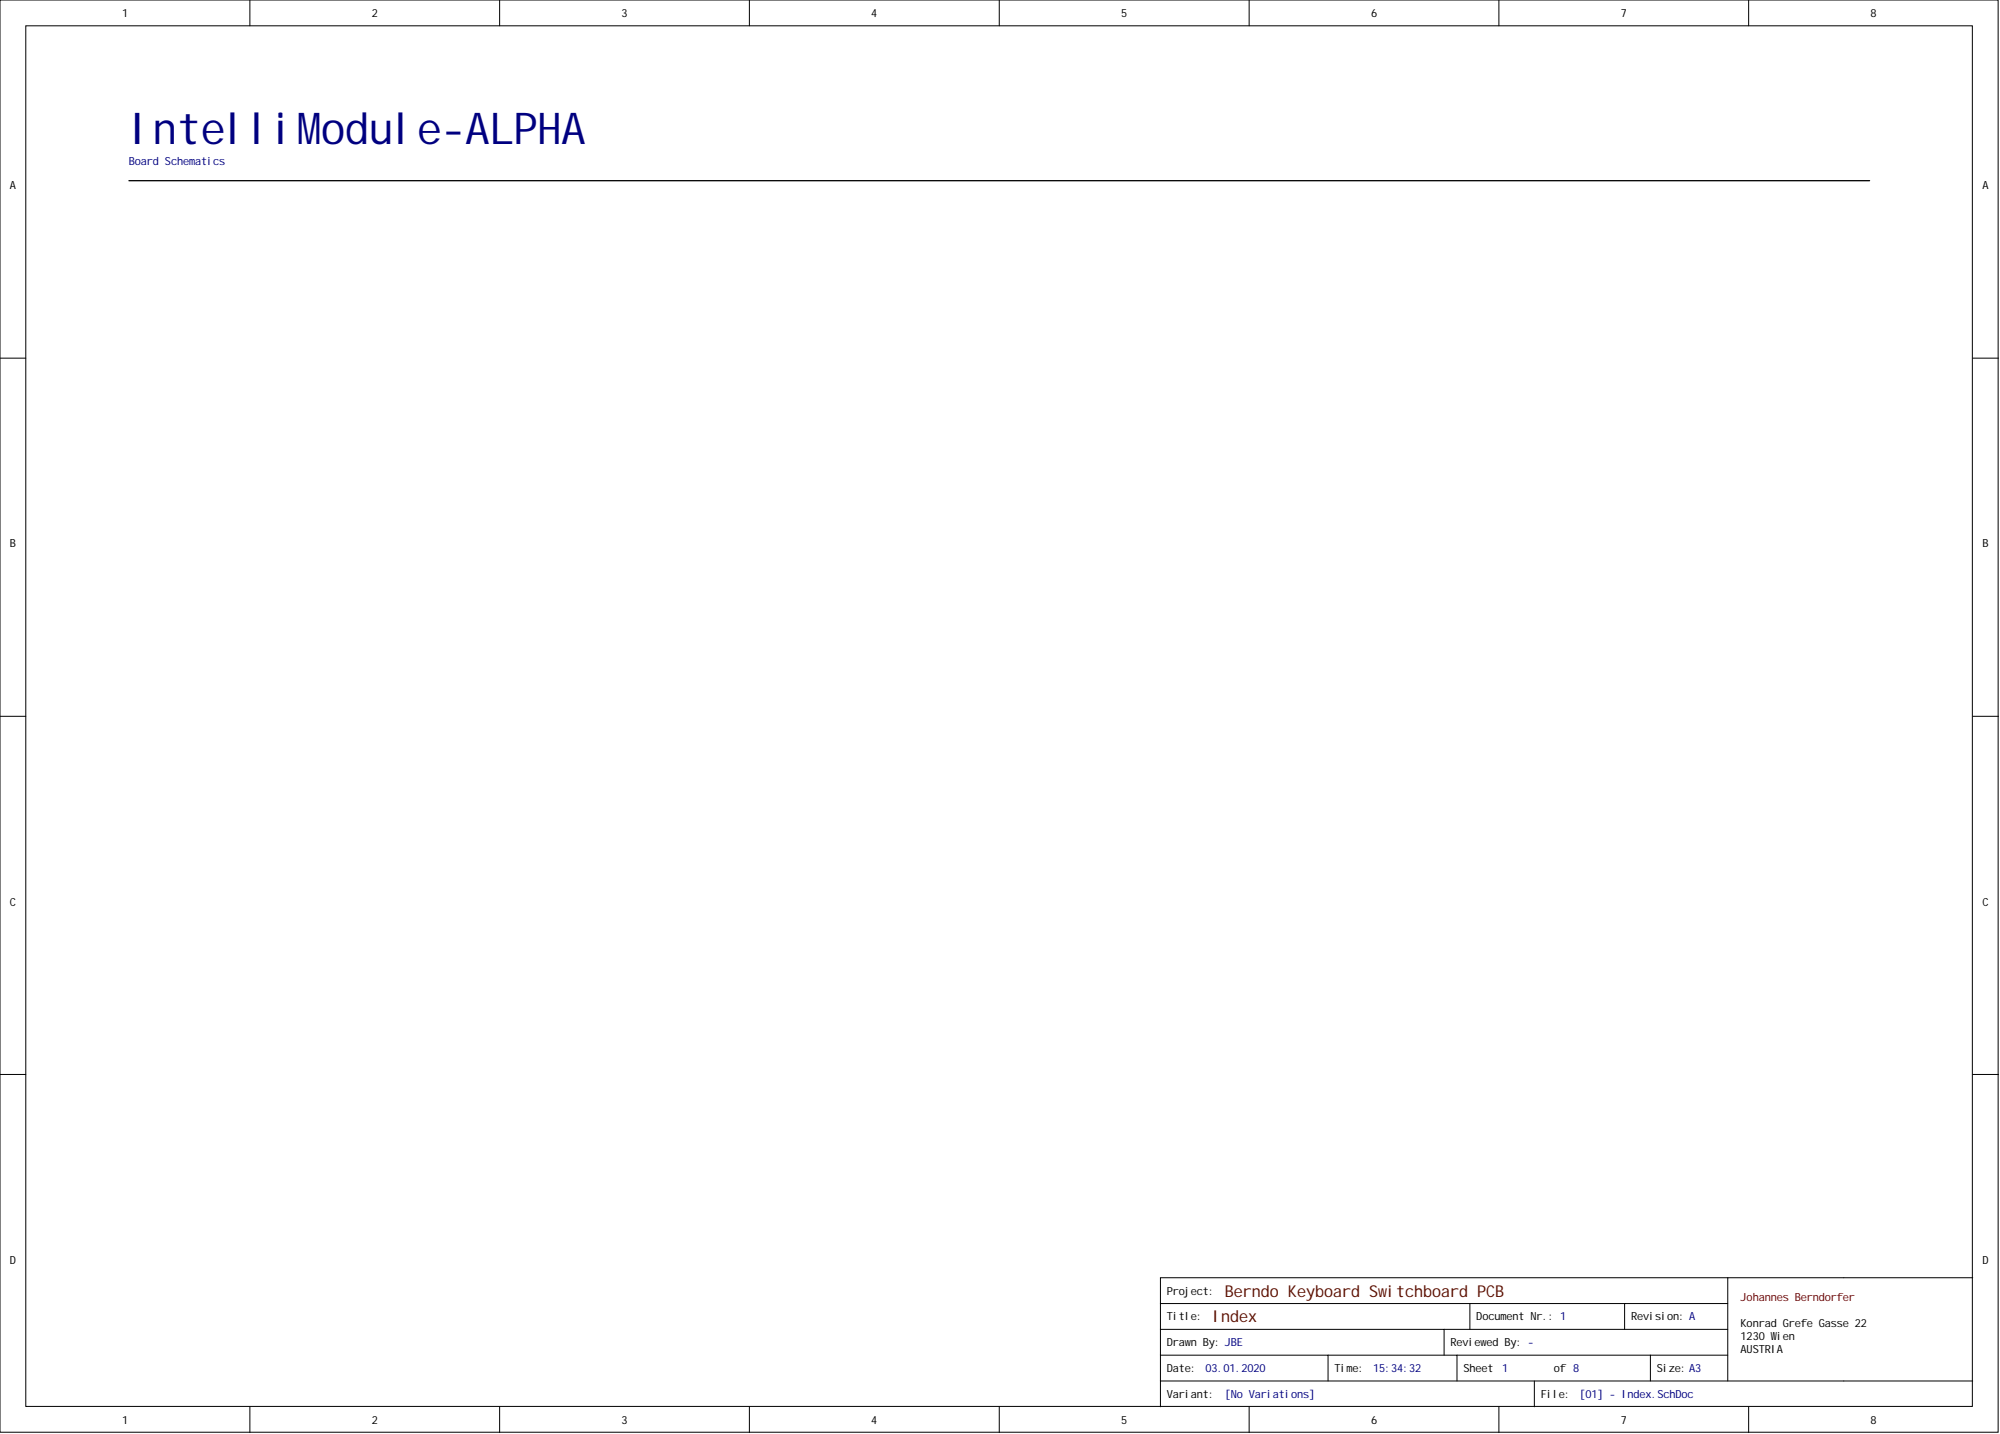
[picture p2: page 1]

Berndo Keyboard Switchboard PCB

Index Title: | Document Nr.: 1 | Revision: A

Drawn By: JBE | Reviewed By: -

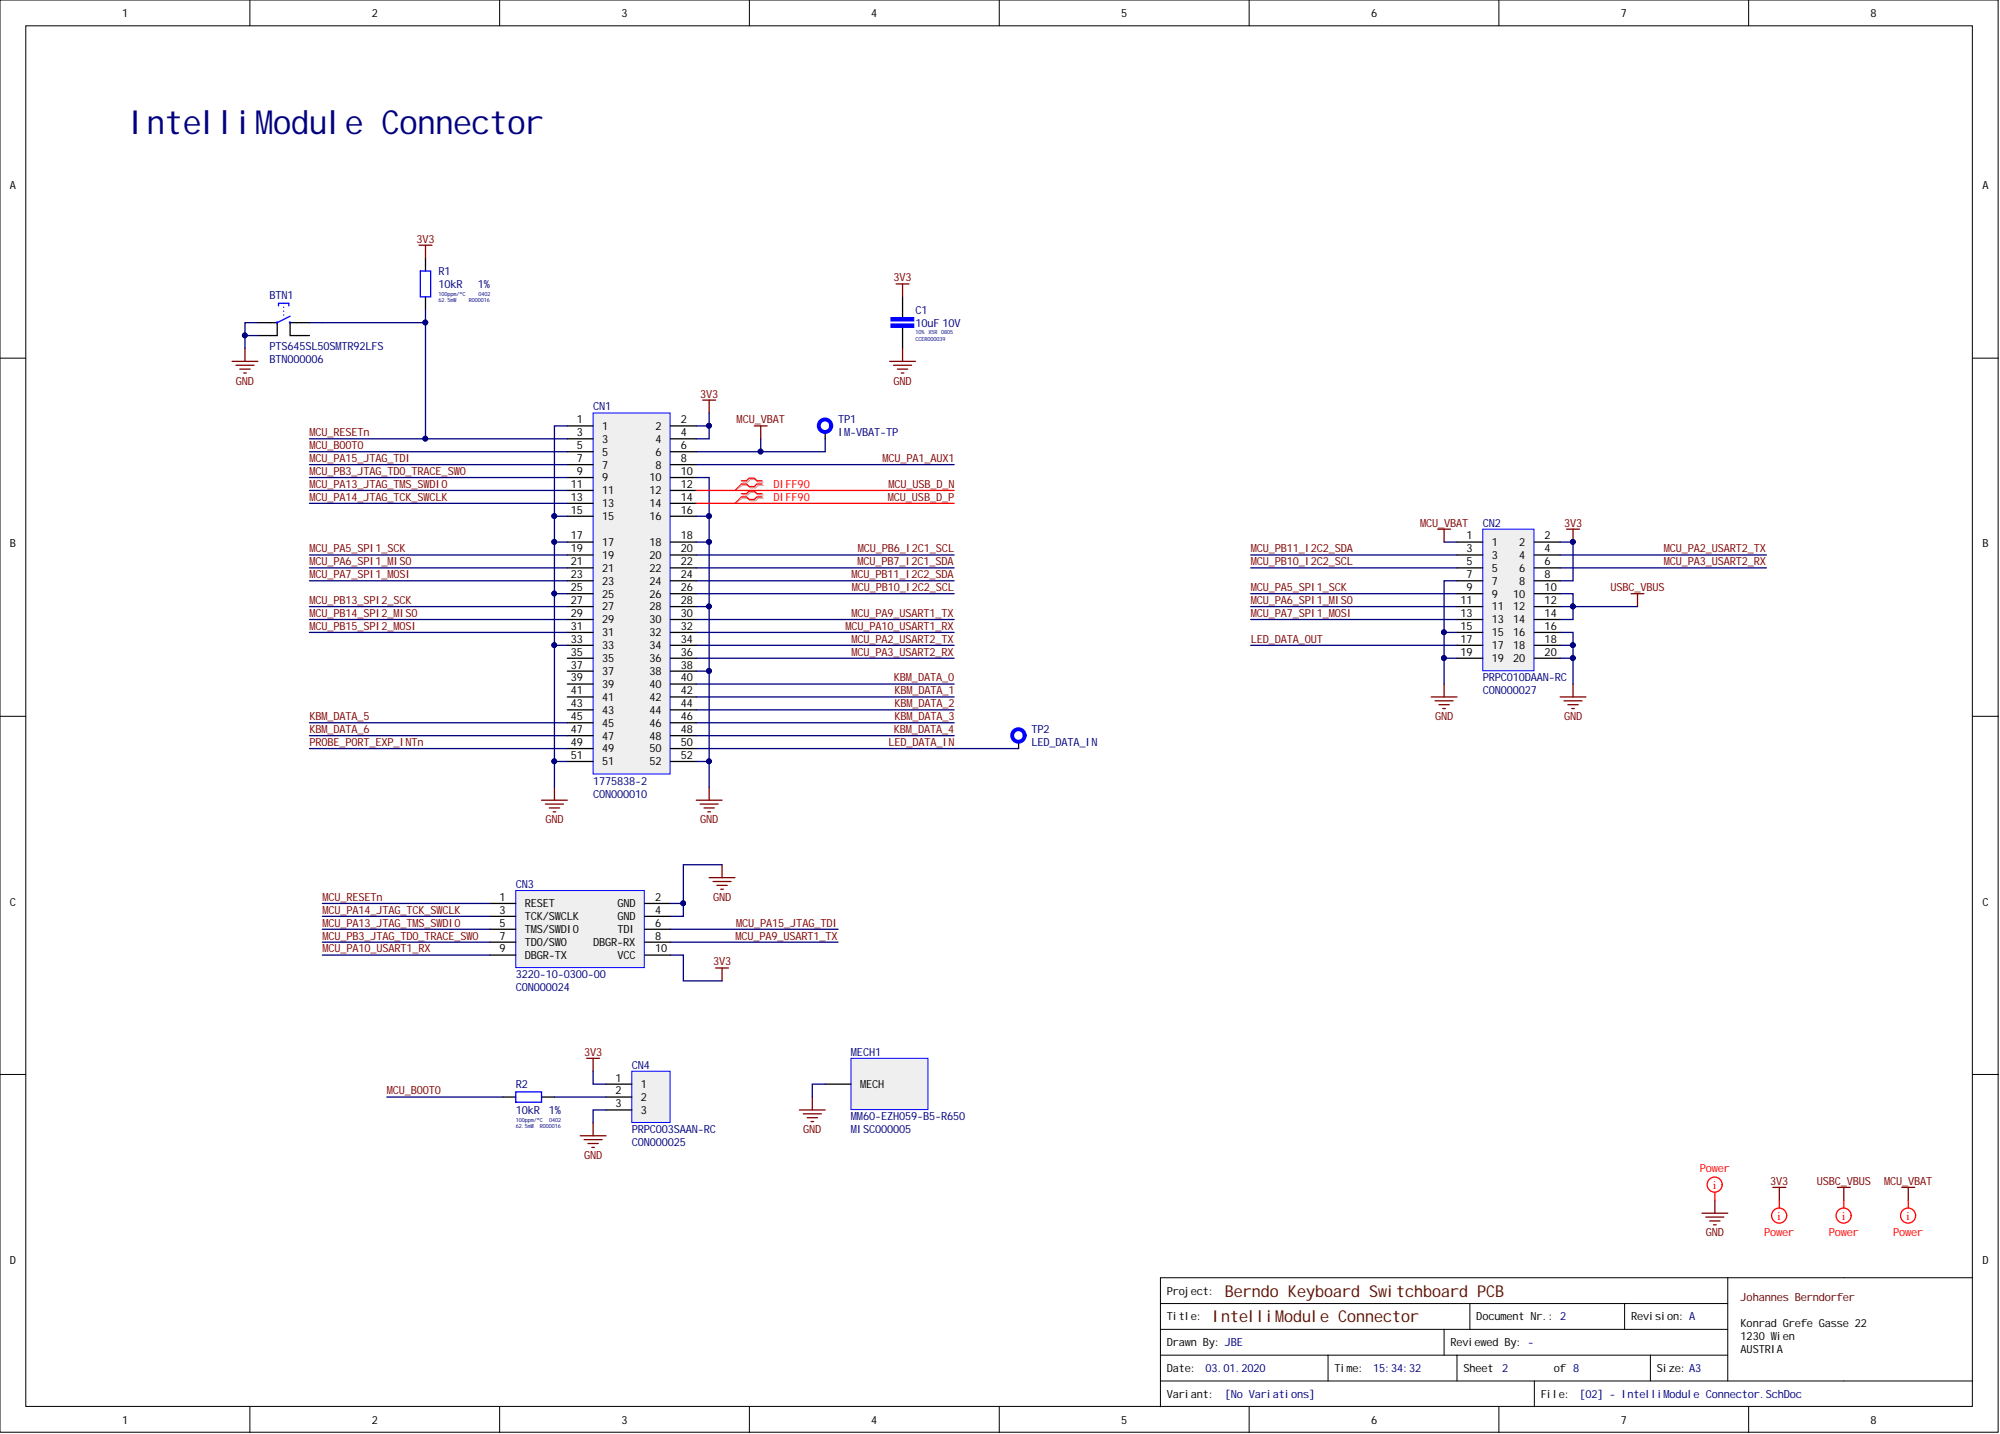
[picture p3: page 2]

Berndo Keyboard Switchboard PCB
IntelliModule Connector

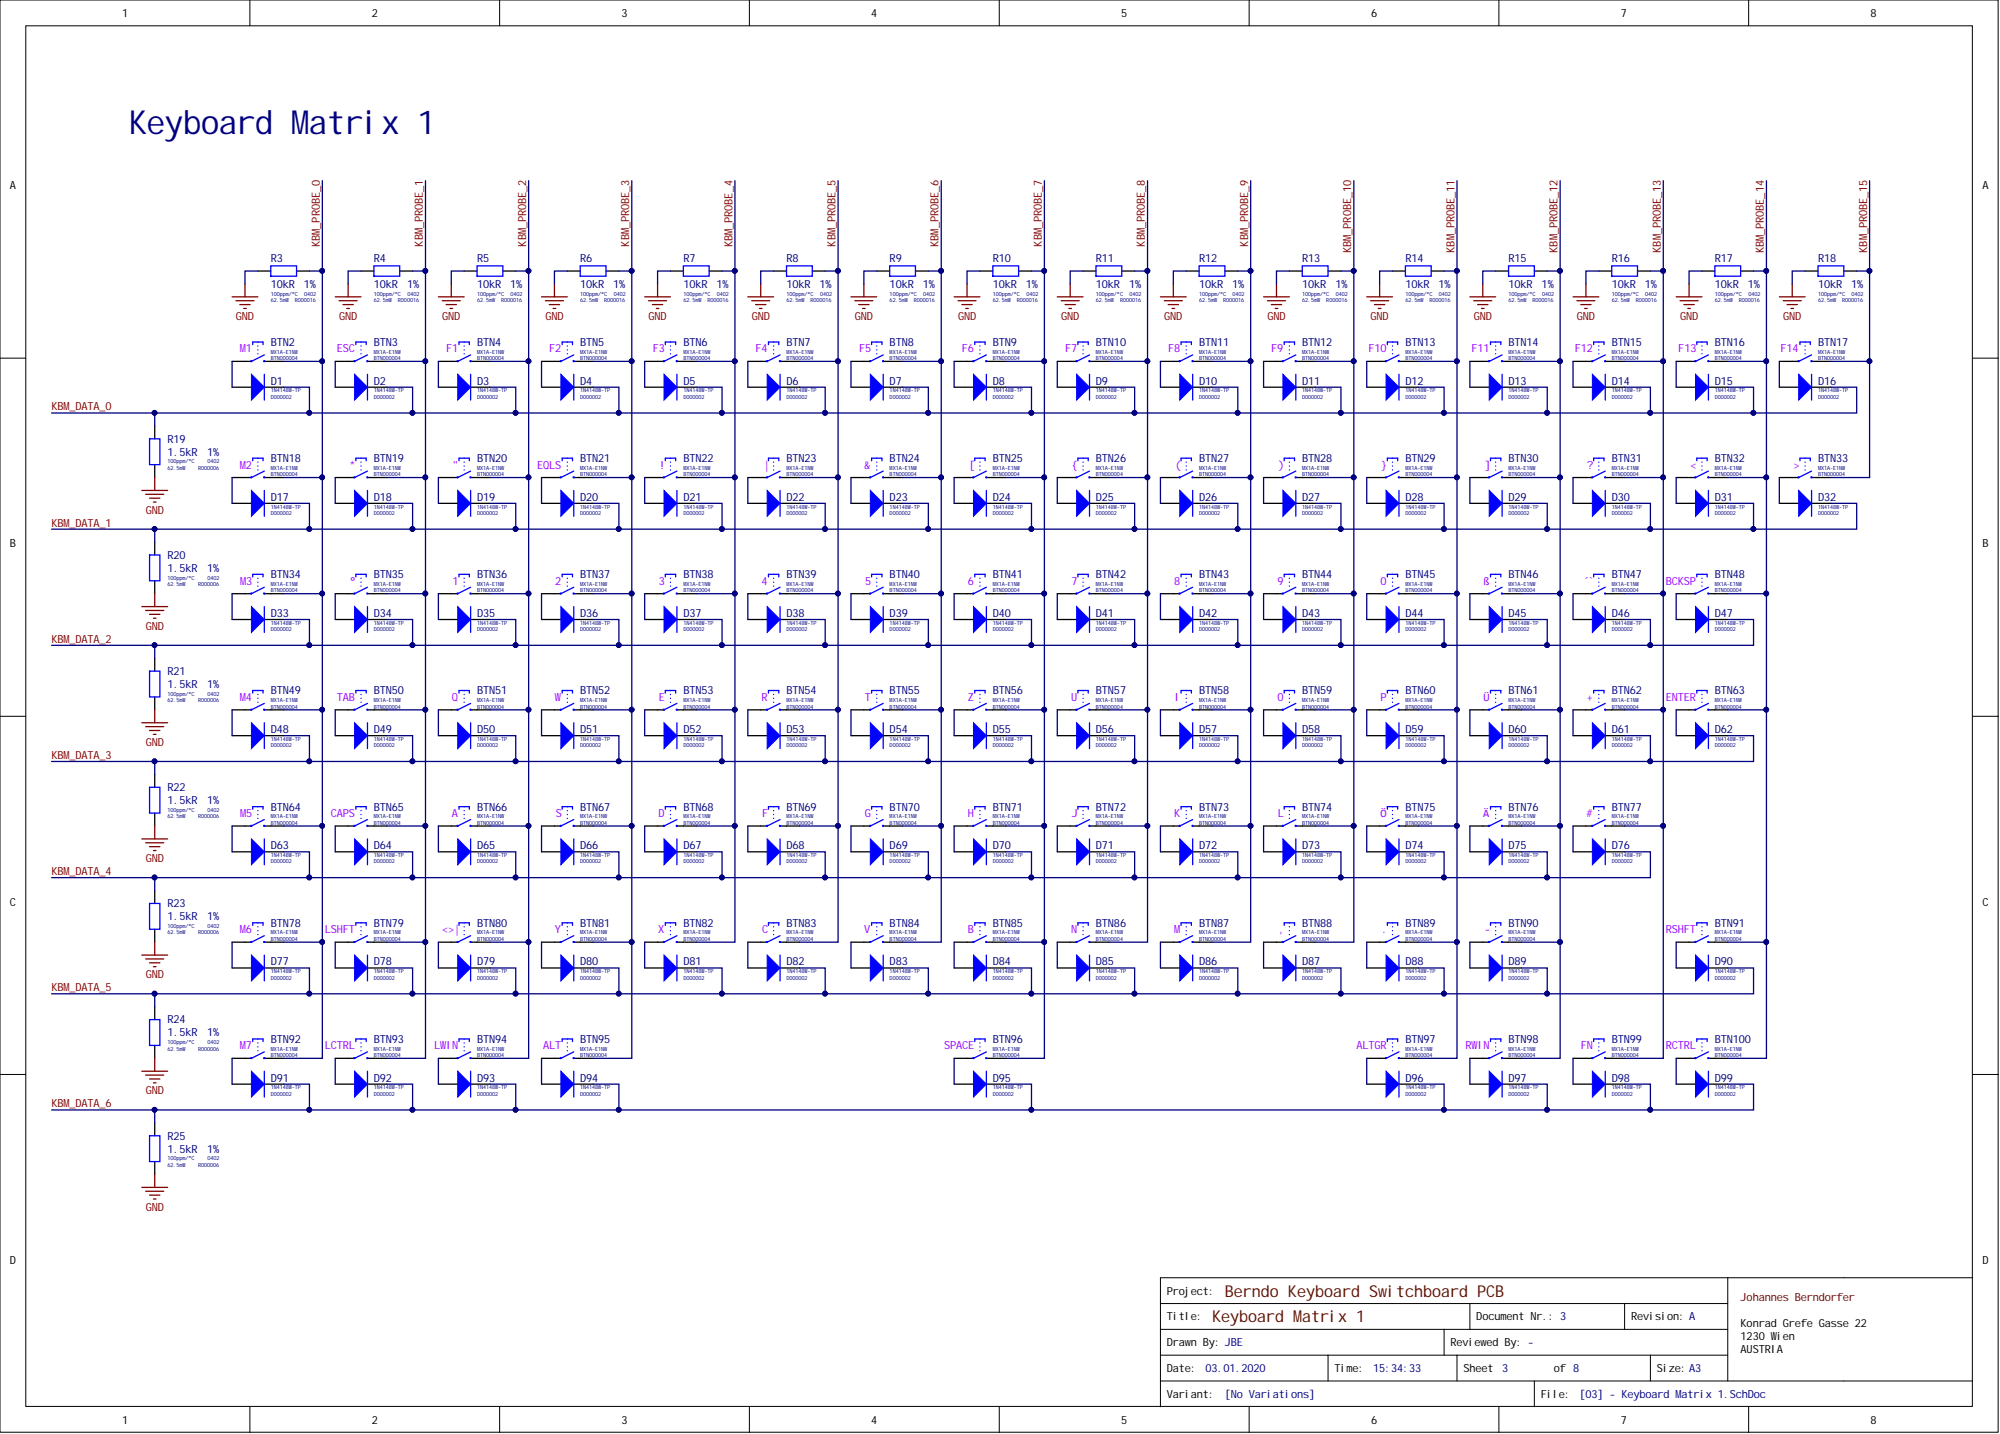
[picture p4: page 3]

KBM_DATA_0

BTN000004 | BTN000004 | BTN000004 | BTN000004 | BTN000004 | BTN000004 | BTN000004 | BTN000004 | BTN000004 | BTN000004 | BTN000004 | BTN000004 | BTN000004 | BTN000004 | BTN000004

KBM_DATA_1

BTN000004 | BTN000004 | BTN000004 | BTN000004 | BTN000004 | BTN000004 | BTN000004 | BTN000004 | BTN000004 | BTN000004 | BTN000004 | BTN000004 | BTN000004 | BTN000004

KBM_DATA_2

KBM_DATA_3

KBM_DATA_4

BTN000004 | BTN000004 | BTN000004 | BTN000004 | BTN000004 | BTN000004 | BTN000004 | BTN000004 | BTN000004 | BTN000004 | BTN000004 | - BTN90 MX1A-E1NW BTN000004

KBM_DATA_5

BTN000004 | BTN000004 | BTN000004 | BTN000004 | BTN000004 | BTN000004 | BTN000004 | BTN000004

Berndo Keyboard Switchboard PCB
Keyboard Matrix 1

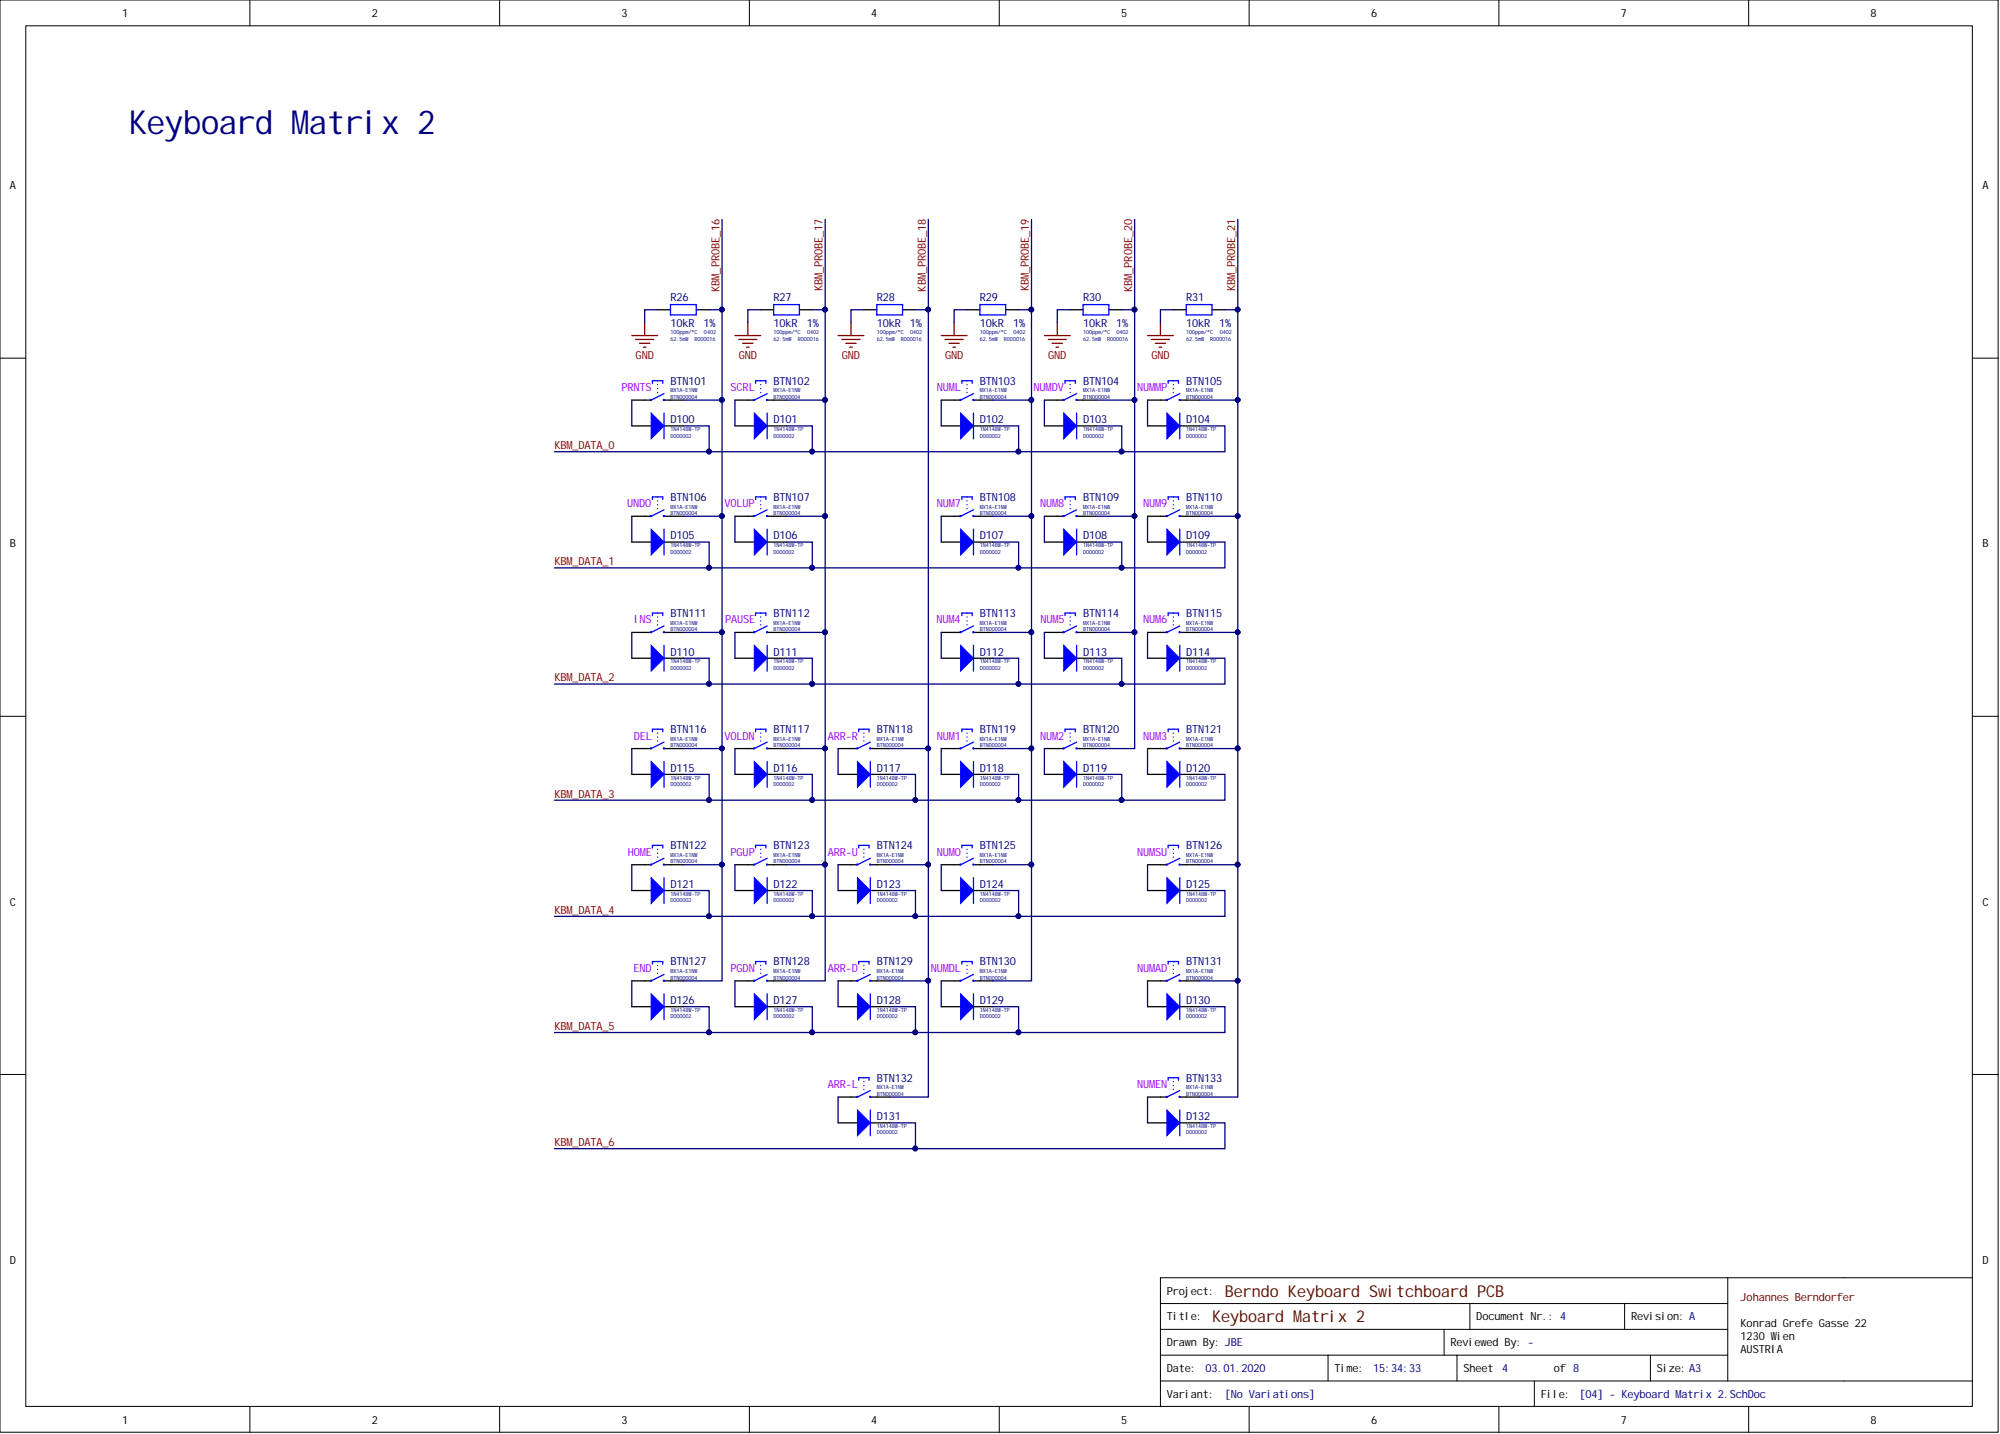
[picture p5: page 4]

KBM_DATA_0

BTN000004 | BTN000004 | BTN000004 | BTN000004

KBM_DATA_1

KBM_DATA_2

BTN000004 | BTN000004 | BTN000004 | BTN000004 | BTN000004

KBM_DATA_3

KBM_DATA_4

Berndo Keyboard Switchboard PCB
Keyboard Matrix 2

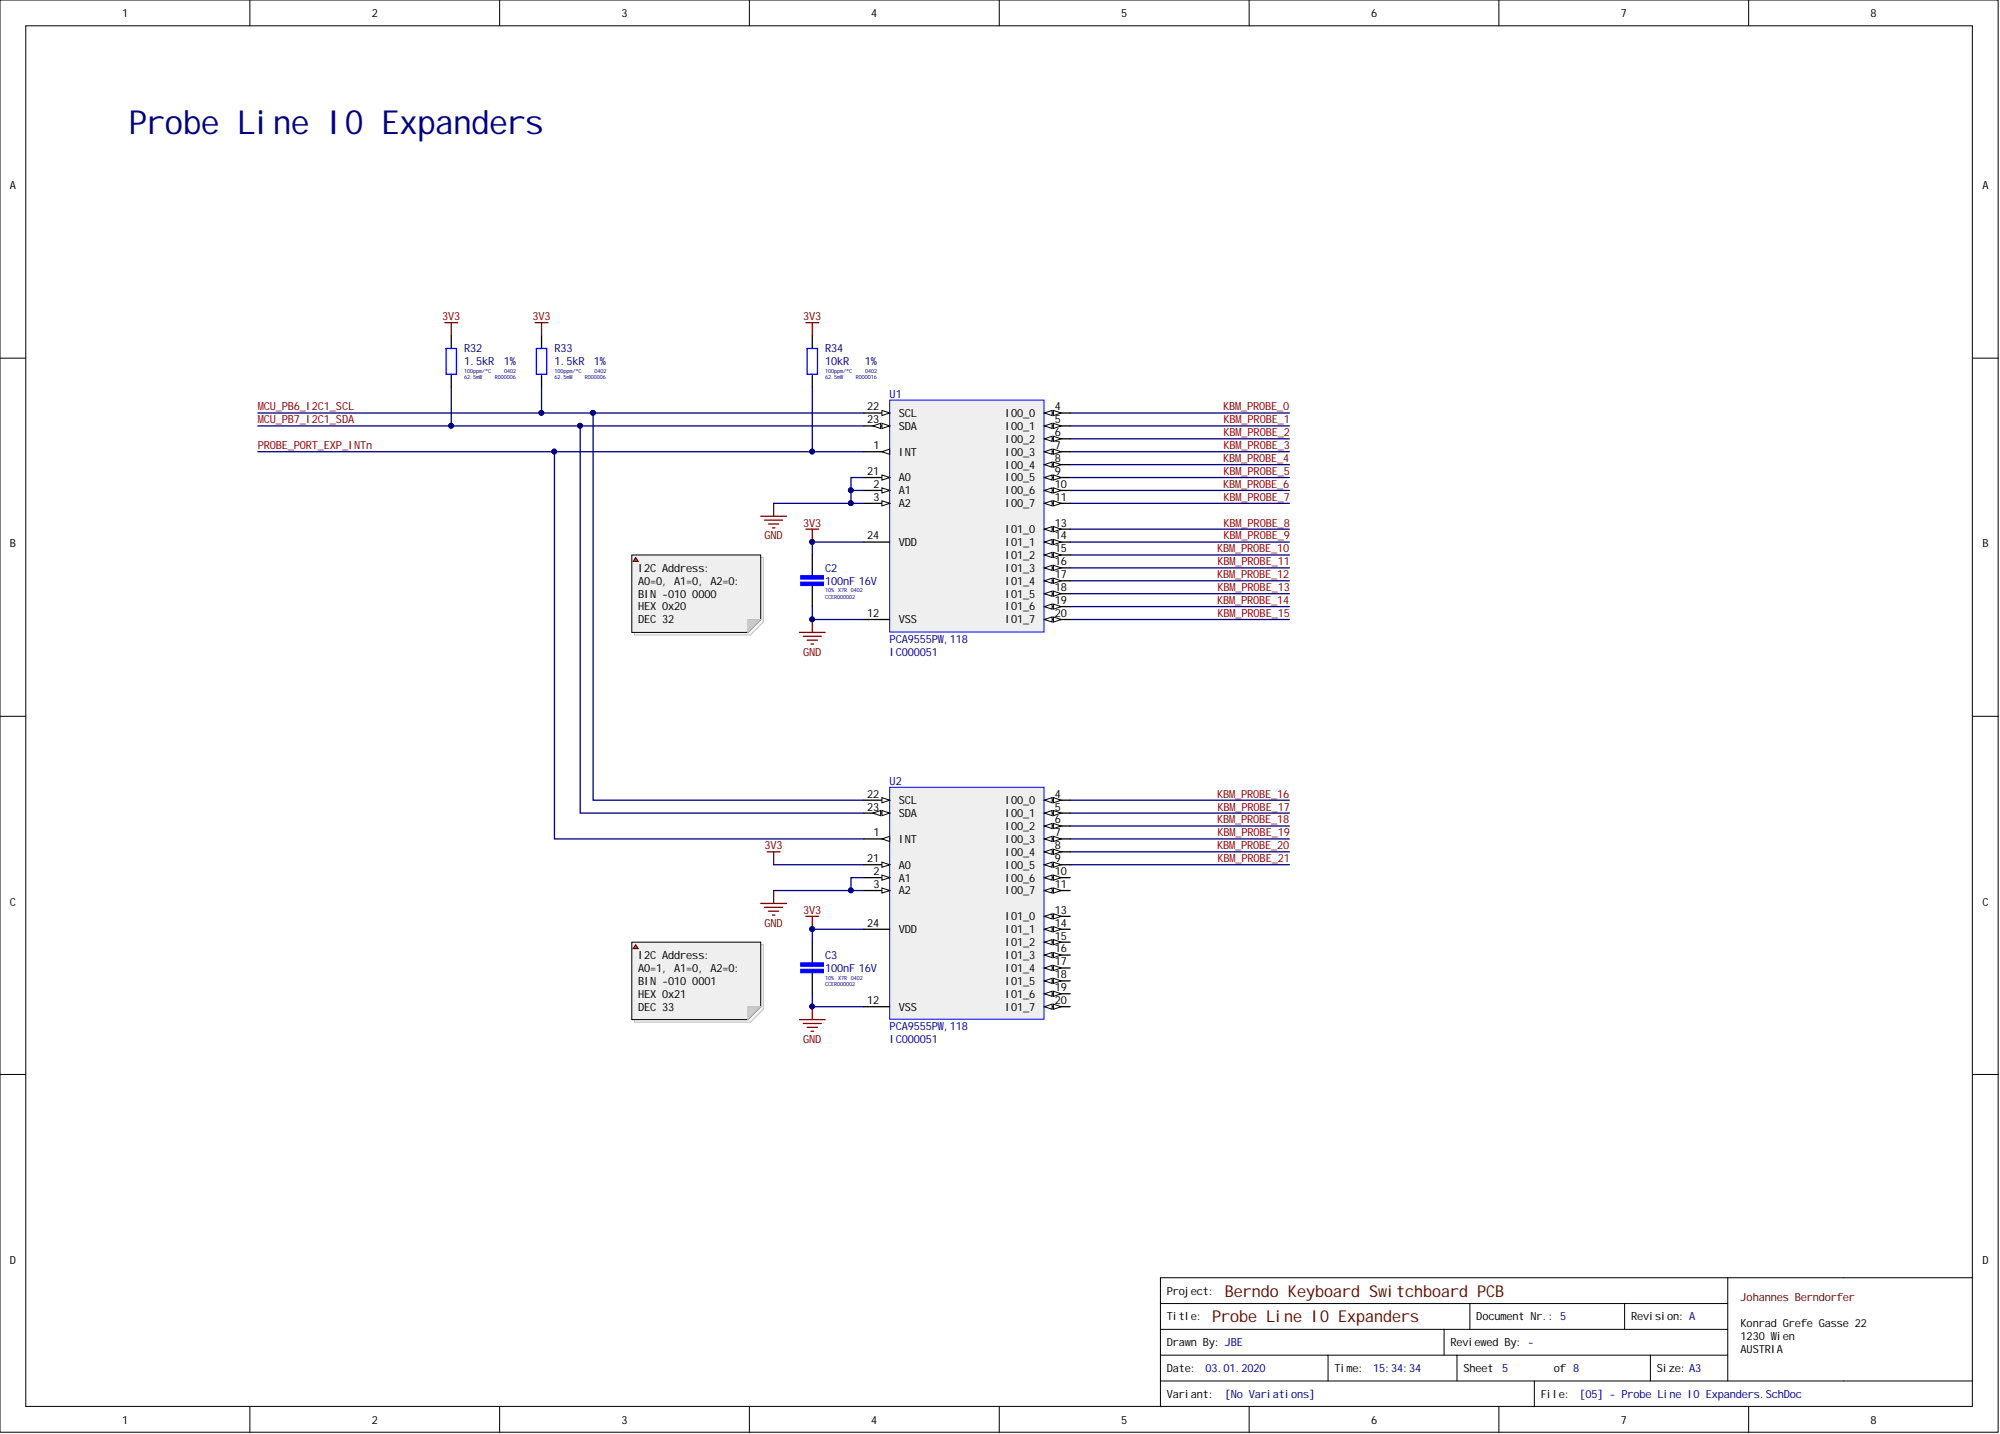
[picture p6: page 5]

Probe Line IO Expanders

Berndo Keyboard Switchboard PCB Docume

Probe Line IO Expanders T i t l e : | n t N r . : | R e v i s i o n : A

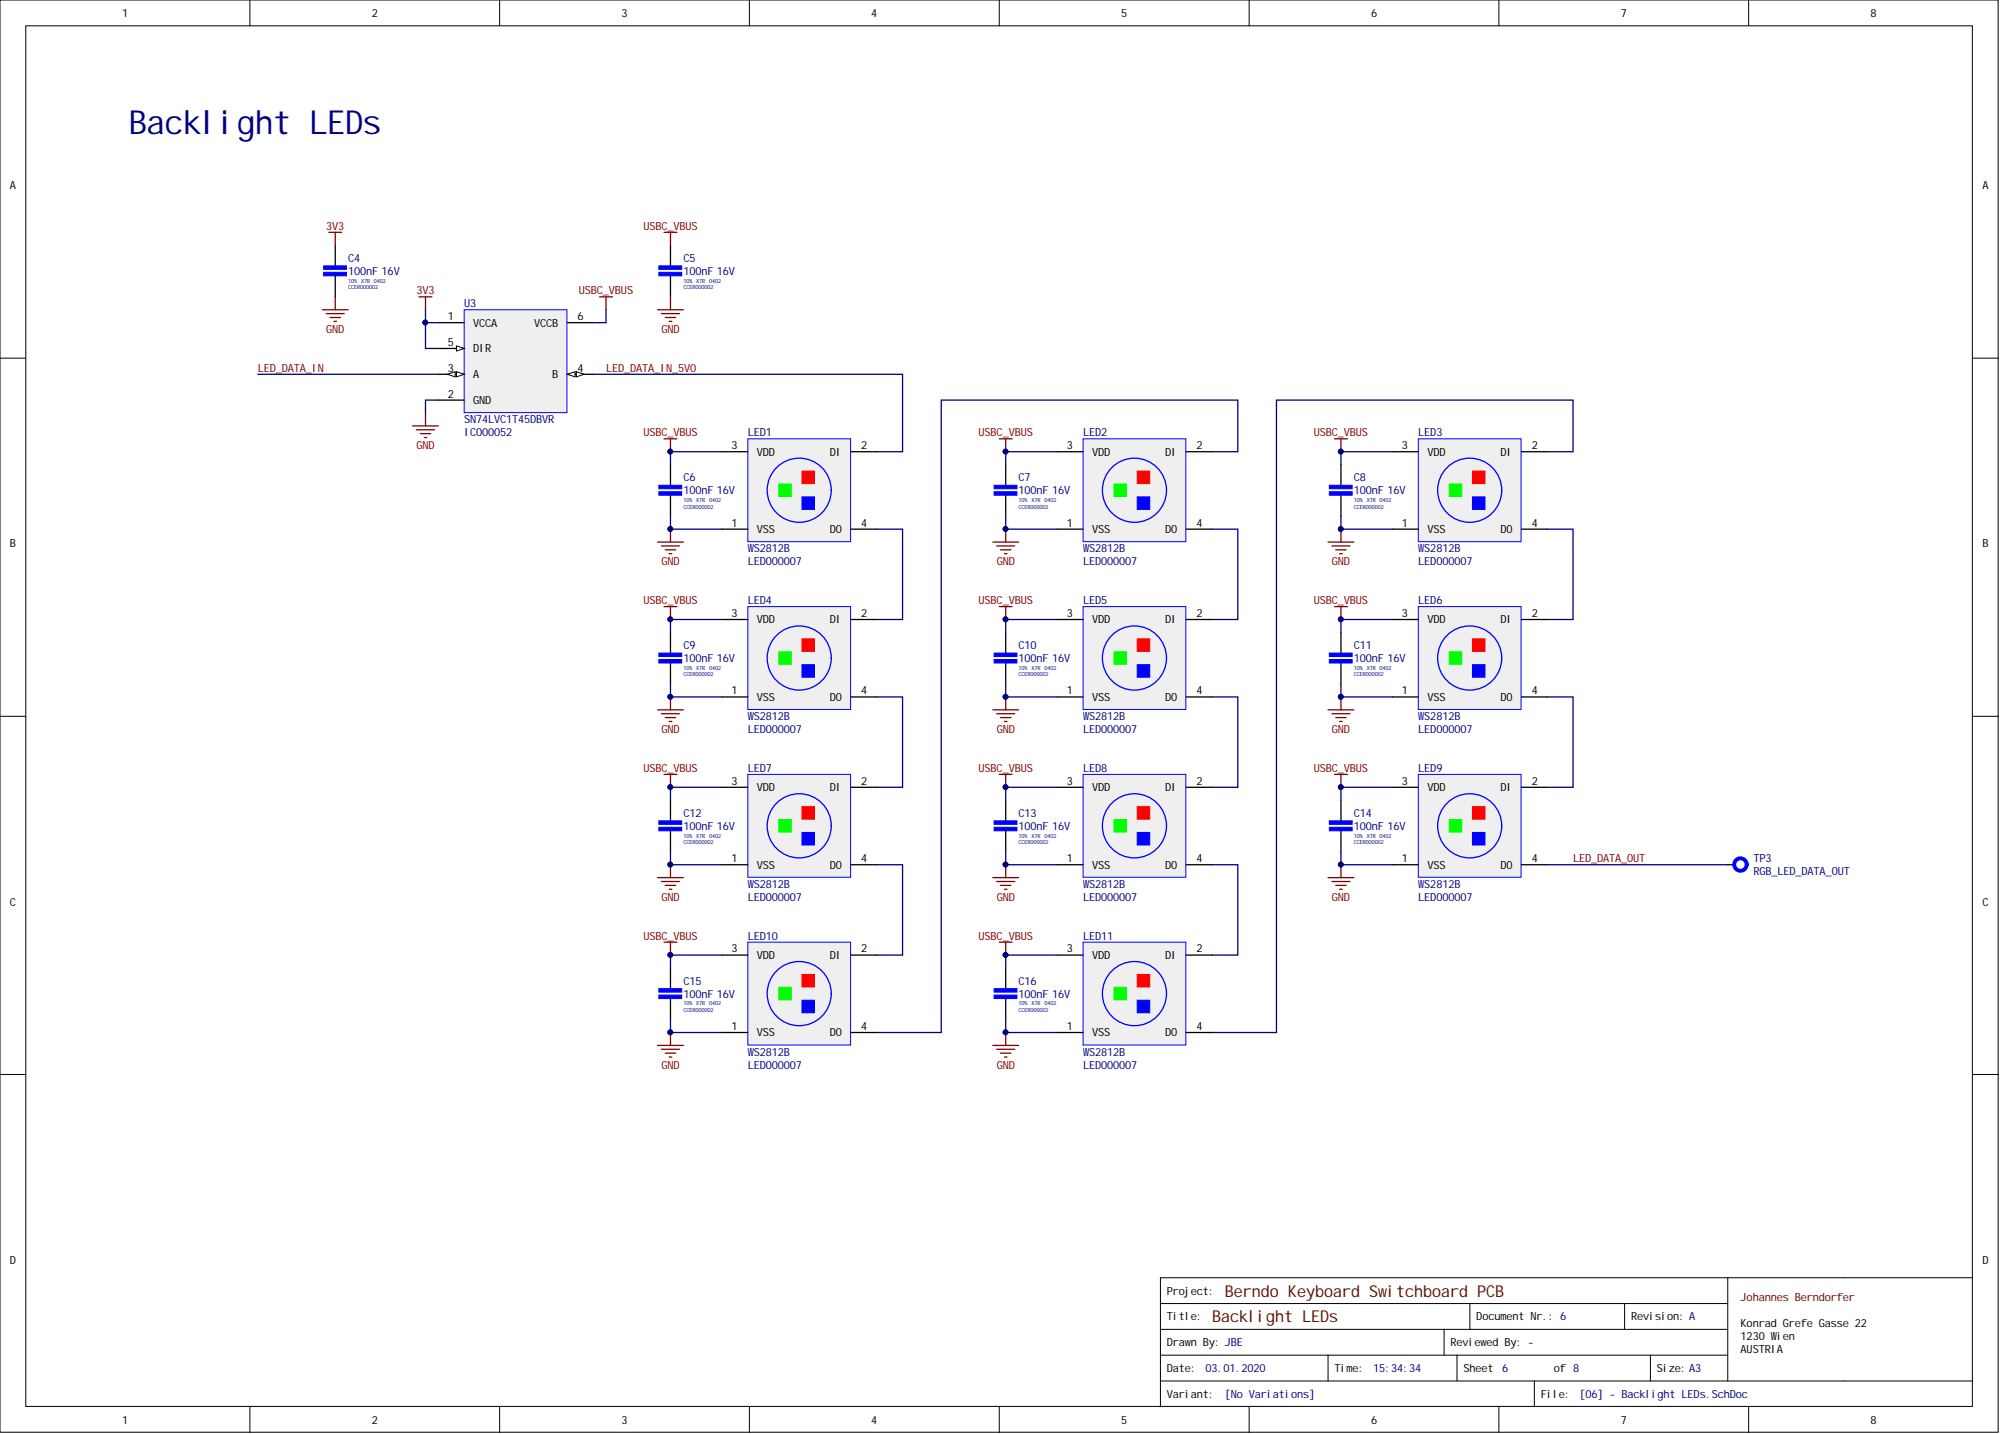
[picture p7: page 6]

Berndo Keyboard Switchboard PCB
Backlight LEDs

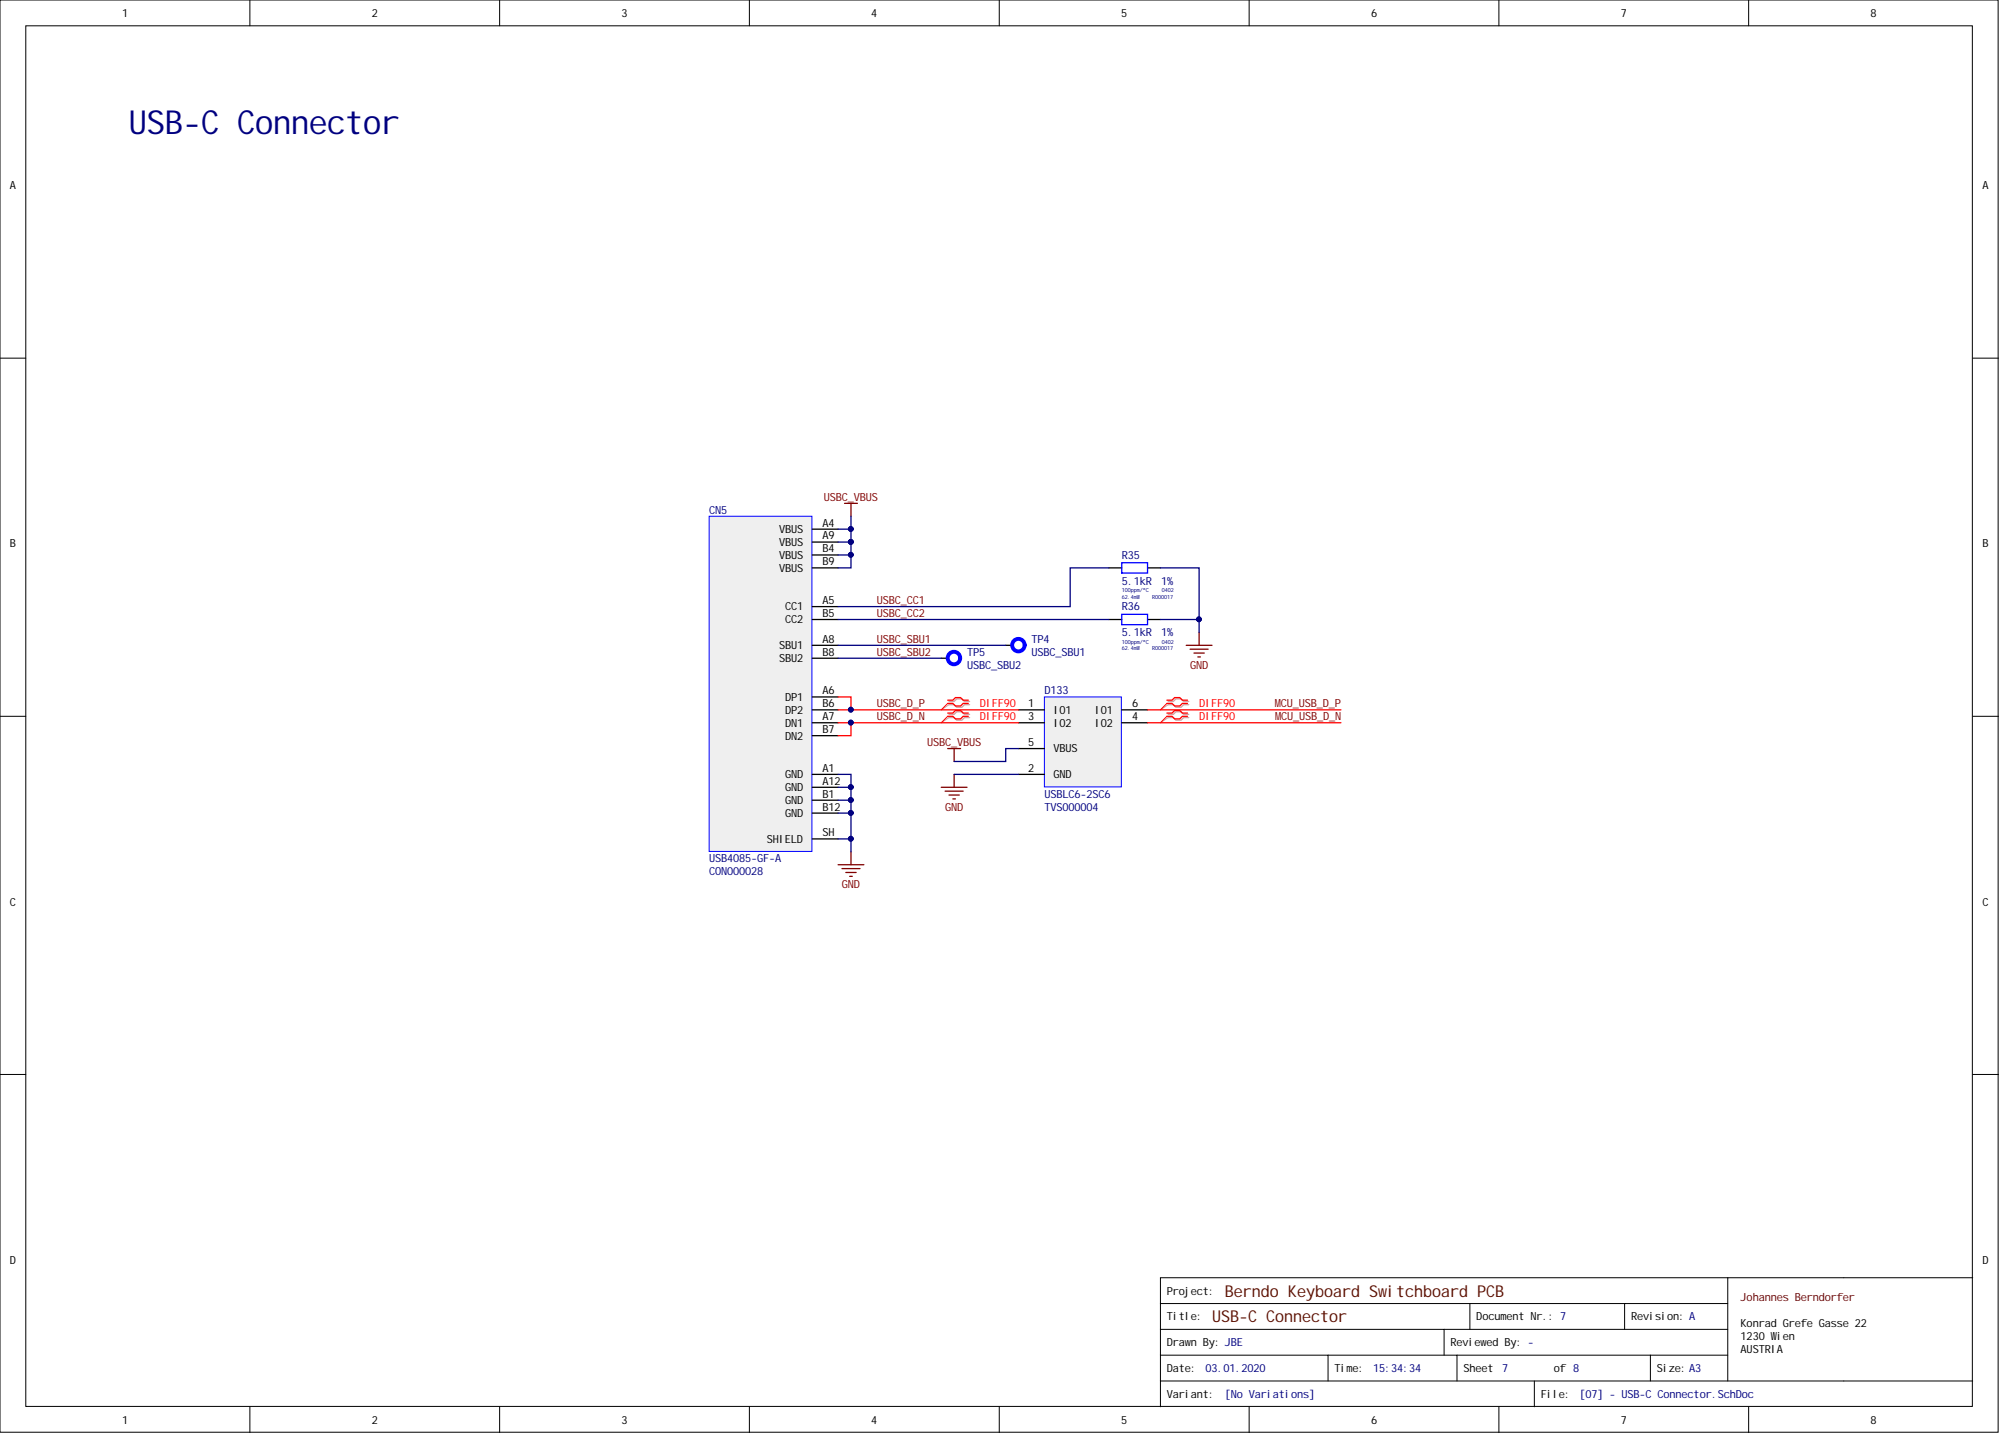
[picture p8: page 7]

Berndo Keyboard Switchboard PCB
USB-C Connector

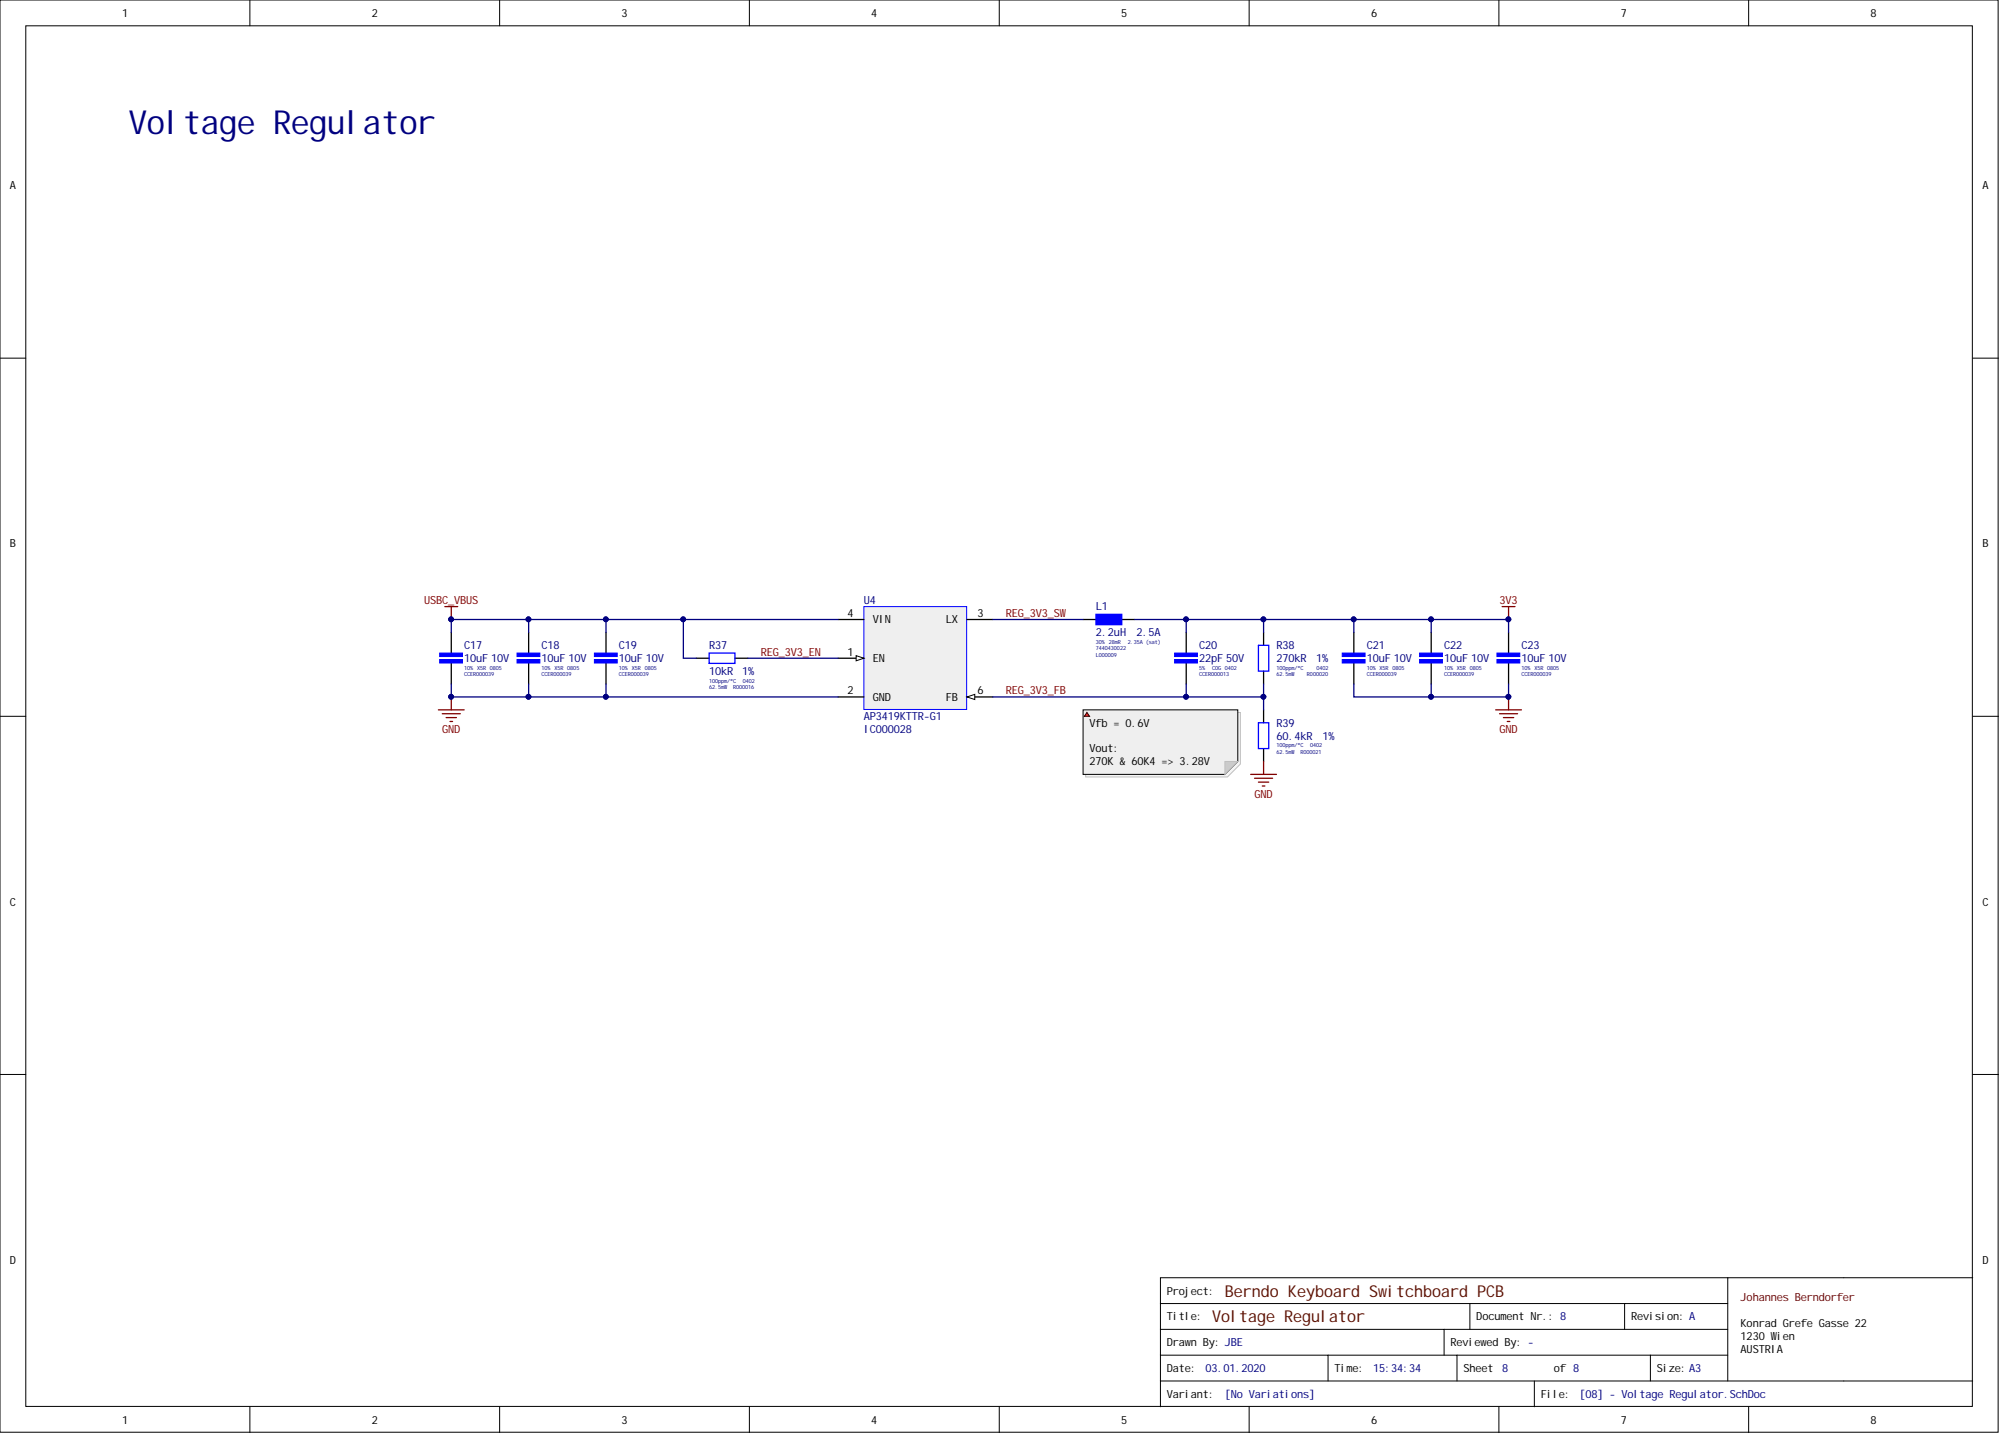
[picture p9: page 8]

Berndo Keyboard Switchboard PCB Docume

Voltage Regulator T i t l e : | n t N r . : | R e v i s i o n : A
