berndoJ/BerndoKeyboard/(list of files, drawings)

Other design files:
hardware/BerndoKeyboard-Switchboard/[01] - Index.SchDoc
hardware/BerndoKeyboard-Switchboard/[02] - IntelliModule Connector.SchDoc
hardware/BerndoKeyboard-Switchboard/[03] - Keyboard Matrix 1.SchDoc
hardware/BerndoKeyboard-Switchboard/[04] - Keyboard Matrix 2.SchDoc
hardware/BerndoKeyboard-Switchboard/[05] - Probe Line IO Expanders.SchDoc
hardware/BerndoKeyboard-Switchboard/[06] - Backlight LEDs.SchDoc
hardware/BerndoKeyboard-Switchboard/[07] - USB-C Connector.SchDoc
hardware/BerndoKeyboard-Switchboard/[08] - Voltage Regulator.SchDoc
hardware/BerndoKeyboard-Switchboard/BerndoKeyboard-Switchboard.PrjPcb
