berndoJ/BerndoKeyboard/firmware/app/src/sys_ws2812.c

#include "sys_ws2812.h"
#include "sys_timer.h"
#include "error.h"
#include "debug.h"
#include "stm32f1xx_hal.h"
#include <stdint.h>

#include <stdlib.h>
#include <stdio.h>

NP32_Instance_t *hw_ws2812_handle;
SYS_InitStatus_t hw_ws2812_init_status = SYS_INIT_STATUS_NOT_INITIALISED;

static NP32_Instance_t _hw_ws2812_handle = {0};

static int8_t _NP32_StartDMA_Call(uint16_t *buf, uint16_t len);

void SYS_WS2812_Init(void)
{
    hw_ws2812_handle = &_hw_ws2812_handle;

    hw_ws2812_handle->LED_Count = 11U;
    hw_ws2812_handle->LED_Disable_Flag = 0;
    hw_ws2812_handle->StartDMA_Call = _NP32_StartDMA_Call;

    if (NP32_Init(hw_ws2812_handle) != 0)
        SYS_ThrowError(SYSERR_FATAL_ERROR, __LINE__, __FILE__, "NP32 INIT ERR");

    hw_ws2812_init_status = SYS_INIT_STATUS_INITIALISED;
}

int8_t _NP32_StartDMA_Call(uint16_t *buf, uint16_t len)
{
    return (HAL_TIM_PWM_Start_DMA(hw_timer2_handle, TIM_CHANNEL_3, (uint32_t *) buf, len) == HAL_OK) ? 0 : -1;
}
