berndoJ/BerndoKeyboard/firmware/app/src/sys_clock.c

#include "sys_clock.h"
#include "error.h"
#include "stm32f1xx_hal.h"

void SYS_Clock_Init(void)
{
    RCC_OscInitTypeDef osc_init;
    RCC_ClkInitTypeDef clk_init;

    osc_init.OscillatorType = RCC_OSCILLATORTYPE_HSE;
    osc_init.HSEState = RCC_HSE_ON;
    osc_init.HSEPredivValue = RCC_HSE_PREDIV_DIV2;
    osc_init.HSIState = RCC_HSI_ON;
    osc_init.PLL.PLLState = RCC_PLL_ON;
    osc_init.PLL.PLLSource = RCC_PLLSOURCE_HSE;
    osc_init.PLL.PLLMUL = RCC_PLL_MUL9;

    if (HAL_RCC_OscConfig(&osc_init) != HAL_OK)
        SYS_ThrowError(SYSERR_FATAL_ERROR, __LINE__, __FILE__, "RCCOSC HAL ERR");
    
    clk_init.ClockType = RCC_CLOCKTYPE_HCLK | RCC_CLOCKTYPE_SYSCLK | RCC_CLOCKTYPE_PCLK1 | RCC_CLOCKTYPE_PCLK2;
    clk_init.SYSCLKSource = RCC_SYSCLKSOURCE_PLLCLK;
    clk_init.AHBCLKDivider = RCC_SYSCLK_DIV1;
    clk_init.APB1CLKDivider = RCC_HCLK_DIV2;
    clk_init.APB2CLKDivider = RCC_HCLK_DIV1;

    if (HAL_RCC_ClockConfig(&clk_init, FLASH_LATENCY_2) != HAL_OK)
        SYS_ThrowError(SYSERR_FATAL_ERROR, __LINE__, __FILE__, "RCCCLK HAL ERR");
}
