berndoJ/BerndoKeyboard/(commit log)

2019-11-12 Initial Commit.
    [BerndoKeyboard-Switchboard.PrjPcb, [01] - Index.SchDoc, [02] - IntelliModule Connector.SchDoc, [03] - Keyboard Matrix 1.SchDoc, [04] - Keyboard Matrix 2.SchDoc]
2019-11-13 Keyboard Matrix 2 Progress.
    [[04] - Keyboard Matrix 2.SchDoc]
2019-11-13 Finished Keyboard Matrix.
    [[02] - IntelliModule Connector.SchDoc, [03] - Keyboard Matrix 1.SchDoc, [04] - Keyboard Matrix 2.SchDoc]
2019-11-13 Finished Preliminary Schematic
    [BerndoKeyboard-Switchboard.PrjPcb, [01] - Index.SchDoc, [02] - IntelliModule Connector.SchDoc, [03] - Keyboard Matrix 1.SchDoc, [04] - Keyboard Matrix 2.SchDoc, [05] - Probe Line IO Expanders.SchDoc, [06] - Backlight LEDs.SchDoc, [07] - USB-C Connector.SchDoc]
2019-11-14 PCB Progress.
2019-11-16 PCB Layout Progress.
    [[02] - IntelliModule Connector.SchDoc]
2019-12-01 Finished PCB
    [BerndoKeyboard-Switchboard.PrjPcb, [02] - IntelliModule Connector.SchDoc]
2019-12-09 Updated Production Outputs
    [BerndoKeyboard-Switchboard.DRL, BerndoKeyboard-Switchboard.GBL, BerndoKeyboard-Switchboard.GBO, BerndoKeyboard-Switchboard.GBP, BerndoKeyboard-Switchboard.GBS, BerndoKeyboard-Switchboard.GTL, BerndoKeyboard-Switchboard.GTO, BerndoKeyboard-Switchboard.GTP]
2019-12-09 Added BOM
    [BerndoKeyboard-Switchboard-BOM-Def-09-12-2019.xlsx, BerndoKeyboard-Switchboard-BOM-Purchase-09-12-2019.xlsx, BerndoKeyboard-Switchboard-BOM-Raw-09-12-2019.xlsx, BerndoKeyboard-Switchboard-BOM.xlsx]
2019-12-19 Updated BOM
    [BerndoKeyboard-BillOfMaterials.xlsx, BerndoKeyboard-Switchboard-BOM-Def-09-12-2019.xlsx, BerndoKeyboard-Switchboard-BOM-Purchase-09-12-2019.xlsx, BerndoKeyboard-Switchboard-BOM-Raw-09-12-2019.xlsx, BerndoKeyboard-Switchboard-BOM-Raw.xlsx, BerndoKeyboard-Switchboard-BOM.xlsx, BerndoKeyboard-Switchboard.PrjPcb]
2019-12-20 Finished Bill of Materials.
    [BerndoKeyboard-BillOfMaterials.xlsx]
2019-12-21 Added order lists for all distributors.
    [BerndoKeyboard-Switchboard-BillOfMaterials.xlsx, BerndoKeyboard-Switchboard-OrderList-DigiKey.xlsx, BerndoKeyboard-Switchboard-OrderList-LCSC.xlsx, BerndoKeyboard-Switchboard-OrderList-Mouser.xlsx]
2019-12-21 Moved free output files to proper location.
    [BerndoKeyboard-Switchboard.DRL, BerndoKeyboard-Switchboard.GBL, BerndoKeyboard-Switchboard.GBO, BerndoKeyboard-Switchboard.GBP, BerndoKeyboard-Switchboard.GBS, BerndoKeyboard-Switchboard.GTL, BerndoKeyboard-Switchboard.GTO, BerndoKeyboard-Switchboard.GTP]
2020-03-01 Tried fixing USB problems. Troubleshooting continues...
    [console.c, isr.c, isr.h]
2020-03-08 Finalised first prototype firmware for BerndoKeyboard.
